bontango/AtariFA/README.md

# AtariFA

An Atari Gen1 pinball MPU on a low cost FPGA — a piggy-back replacement CPU board that
sits on the original Atari edge connectors, emulates the MC6800, provides RAM and ROM and
replaces most of the TTL around it.

Covers **Atarians, Time 2000, Airborne Avenger, Middle Earth and Space Riders**: all five
game ROMs live in the FPGA at once and are picked with a 3-bit DIP switch, with a free-play
option overlaid on top.

Ralf Thelen ('bontango') · <https://lisy.dev>

## User manuals

**Read online:** <https://bontango.github.io/AtariFA/>

- [User manual HW 1.x (English)](https://bontango.github.io/AtariFA/AtariFA_HWv1_x_user_manual.html)
- [Bedienungsanleitung HW 1.x (Deutsch)](https://bontango.github.io/AtariFA/AtariFA_HWv1_x_Bedienungsanleitung.html)
- [Manuel d'utilisation HW 1.x (Français)](https://bontango.github.io/AtariFA/AtariFA_HWv1_x_manuel_utilisateur.html)

---

## Boards

The same design runs on three piggy-back boards, across two FPGA families. They share
**one** top level (`top/AtariFA.vhd`) and one source tree; what differs per board is a
handful of pin locations, one constant, and — for the Cyclone IV board — which folder the
memory and PLL megafunctions come out of.

| Variant | Board | FPGA | Status |
|---|---|---|---|
| `cyclone_10_pcb` | AtariFA prototype (hardware version 0.7) with the lisy.dev Cyclone 10 piggy-back board - prototype only | 10CL006YE144C8G | lead variant, hardware tested through SW 0.1.5 |
| `cyclone_10_dev_open` | AtariFA PCB v1.0 carrying the 'dev_open' Cyclone 10 board | 10CL006YE144C8G | hardware tested on the bench since SW 0.3.0 |
| `cyclone_IV_dev_open` | AtariFA PCB v1.0 carrying the 'dev_open' board with a Cyclone IV | EP4CE6E22C8 | **not** hardware tested |

The version on the boot info display reads `<BoardId>.<SW_SUB1>.<SW_SUB2>`, so the leading
digit tells you which board you are looking at: `0.1.5` is the PCB board, `1.1.5` the
dev_open one, `2.1.5` the Cyclone IV dev_open one.

Differences between the boards, in full: pin-out; the dev_open boards have four on-board
status LEDs instead of three (D4 spare) and their own reset switch, and they route 3 of the
8 debug lines to the logic analyser header instead of all 8. The two dev_open variants are
the *same* board with a different chip on it: both are E144 with 6272 LE and 30 M9K, so the
design fits unchanged, but PIN_22 is a user I/O only on the Cyclone 10 — `dip_opt[1]` and
`dip_opt[3]` move one place each for the Cyclone IV.

## Layout

```
top/            the one top level, shared by every variant
rtl/common/     all functional modules + the version and type packages
rtl/cyclone_10/ the megafunctions generated for that FPGA family
rtl/cyclone_IV/ the same three, generated for Cyclone IV E - picked via RtlFamily
rom/            game ROMs, the sound ROM and the speech PCM
variants/<name>/  variant_pkg.vhd  BOARD_ID
                  device.tcl       FAMILY / DEVICE / Quartus version
                  pins.tcl         the pin locations
                  AtariFA.sdc      timing constraints
                  AtariFA.qpf      Quartus project file
                  AtariFA.cof      .sof -> .jic conversion setup
                  AtariFA.qsf      GENERATED - do not edit
scripts/        gen_qsf.ps1, check.ps1, build.ps1, release.ps1 + the .qsf fragments
bin/            release artefacts per board + changelog.txt
docs/           analyses, schematics, PinMAME reference sources
archive/        historic modules, in no build
```

## Documentation

**User manual: [online](https://bontango.github.io/AtariFA/AtariFA_HWv1_x_user_manual.html)**
(source `docs/AtariFA_HWv1_x_user_manual.html`) — for
whoever puts the board into a machine: DIP switches, boot sequence, sound paths, LEDs, free play.
In German: [online](https://bontango.github.io/AtariFA/AtariFA_HWv1_x_Bedienungsanleitung.html)
(`docs/AtariFA_HWv1_x_Bedienungsanleitung.html`), in French:
[online](https://bontango.github.io/AtariFA/AtariFA_HWv1_x_manuel_utilisateur.html)
(`docs/AtariFA_HWv1_x_manuel_utilisateur.html`).
Same chapter numbering, so a hint like "see chapter 4.3" fits all three.

Everything else in `docs/` is development material: measurements, schematic extracts and the
analyses behind individual design decisions. [`docs/WORKFLOW.md`](docs/WORKFLOW.md) is for working
on the source, not for using the board.

## Build

```powershell
scripts\check.ps1              # analysis & synthesis of every variant, fast
scripts\check.ps1 -Fit         # + fitter and timing, compared against scripts\baseline.csv
scripts\build.ps1 cyclone_10_pcb   # full compile + .jic
scripts\release.ps1 -Note "..."    # build all, copy to bin\, write changelog
```

Quartus Prime 22.1std.2 Lite Edition, `C:\intelFPGA_lite\22.1std\`. `quartus_sh` is not on
the PATH; the scripts know where it lives.

**Never edit `variants/<name>/AtariFA.qsf`** — it is generated. Change `device.tcl`,
`pins.tcl`, `variant.psd1` or the `scripts/files_*.tcl` lists and rerun `gen_qsf.ps1`
(`check.ps1` and `build.ps1` do that for you). Quartus writes into the file by itself when
the project is open in the IDE, which is exactly why it is regenerated before every build.

## Repository note

This repository used to be the single flat project folder `N:\Projekte\FPGA Atari\AtariFA`.
Its history moved here on 06.08.2026 when the second board variant made one shared tree
necessary. The two old folders `AtariFA\` and `AtariFA_dev_open\` are kept as a backup until
the rebuilt design has been on hardware — **do not commit or push from them.**

## Third party

CPU core `rtl/common/cpu68.vhd` by John Kent. Memory map, display mapping and the
switch/DIP handlers follow PinMAME `src/wpc/atari.c` (reference copies in `docs/`).
