bontango/AtariFA/tools/listing.txt

==============================================================================
AtariFA — Middle Earth 608/609 — 6800 Disassembly
==============================================================================
  ROM2 (609): 0x7000–0x77FF   ROM1 (608): 0x7800–0x7FFF
  RESET=7000  NMI=7EC6  IRQ=26F8  SWI=394E

━━━━━━━━━━━━━━━━━━━━━━━━━━━━━━━━━━━━━━━━━━━━━━━━━━━━━━━━━━━━━━━━━━━━━━━━━━━━━━
BOOT PATH TRACE  (from RESET=7000, call depth ≤ 6, max 8000 insn)
━━━━━━━━━━━━━━━━━━━━━━━━━━━━━━━━━━━━━━━━━━━━━━━━━━━━━━━━━━━━━━━━━━━━━━━━━━━━━━
  7000: 8E 00 60   ROM2_START:  LDS    #$0060
  7003: CE 11 FF                LDX    #$11FF
  7006: 6F 00 09                CLR    $00,X
  7008: 09 8C 10                DEX    
  7009: 8C 10 0F                CPX    #$100F
  700C: 26 F8 7A                BNE    $7006
  700E: 7A 00 C4                DEC    $00C4
  7011: 4F CE 20                CLRA   
  7012: CE 20 4F                LDX    #$204F
  7015: E6 00 2A                LDAB   $00,X
  7017: 2A 01 4C                BPL    $701A
  7019: 4C 49 09                INCA   
  701A: 49 09 8C                ROLA   
  701B: 09 8C 20                DEX    
  701C: 8C 20 4B                CPX    #$204B
  701F: 26 F4 CE                BNE    $7015
  7021: CE 7E 08                LDX    #$7E08
  7024: F6 20 0D                LDAB   $200D   ; DIP_STROBE13  *** IO: DIP_STROBE13
  7027: 2B 03 CE                BMI    $702C
  7029: CE 7E 28                LDX    #$7E28
  702C: BD 78 19                JSR    $7819
  7819: 5F DF 13                CLRB   
  781A: DF 13 9B                STX    $13   ; DISP_RAM+$13
  781C: 9B 14 D9                ADDA   $14   ; DISP_RAM+$14
  781E: D9 13 D7                ADCB   $13   ; DISP_RAM+$13
  7820: D7 13 97                STAB   $13   ; DISP_RAM+$13
  7822: 97 14 DE                STAA   $14   ; DISP_RAM+$14
  7824: DE 13 39                LDX    $13   ; DISP_RAM+$13
  7826: 39 B7 40                RTS    
          ; return → 702F
  702F: A6 00 97                LDAA   $00,X
  7031: 97 DF A6                STAA   $DF
  7033: A6 01 97                LDAA   $01,X
  7035: 97 E0 BD                STAA   $E0
  7037: BD 7F E9                JSR    $7FE9
  7FE9: 86 88 97                LDAA   #$88
  7FEB: 97 1C 97                STAA   $1C   ; DISP_RAM+$1C
  7FED: 97 1D CE                STAA   $1D   ; DISP_RAM+$1D
  7FEF: CE 00 10                LDX    #$0010
  7FF2: 09 A7 00                DEX    
  7FF3: A7 00 8C                STAA   $00,X
  7FF5: 8C FF FF                CPX    #$FFFF
  7FF8: 26 F8 39   VECTORS:     BNE    $7FF2
  7FFA: 39 4E 7E                RTS    
          ; return → 703A
  703A: C6 04 B6                LDAB   #$04
  703C: B6 20 03                LDAA   $2003   ; DIP_STROBE3  *** IO: DIP_STROBE3
  703F: 2A 02 C6                BPL    $7043
  7041: C6 06 D7                LDAB   #$06
  7043: D7 22 CE                STAB   $22   ; LAMP_RAM+$22
  7045: CE 7D F0                LDX    #$7DF0
  7048: 4F F6 20                CLRA   
  7049: F6 20 0F                LDAB   $200F   ; DIP_STROBE15  *** IO: DIP_STROBE15
  704C: 2A 01 4C                BPL    $704F
  704E: 4C 48 F6                INCA   
  704F: 48 F6 20                ASLA   
  7050: F6 20 0E                LDAB   $200E   ; DIP_STROBE14  *** IO: DIP_STROBE14
  7053: 2A 01 4C                BPL    $7056
  7055: 4C BD 78                INCA   
  7056: BD 78 19                JSR    $7819
  7819: 5F DF 13                CLRB     <<<
  781A: DF 13 9B                STX    $13   ; DISP_RAM+$13  <<<
  781C: 9B 14 D9                ADDA   $14   ; DISP_RAM+$14  <<<
  781E: D9 13 D7                ADCB   $13   ; DISP_RAM+$13  <<<
  7820: D7 13 97                STAB   $13   ; DISP_RAM+$13  <<<
  7822: 97 14 DE                STAA   $14   ; DISP_RAM+$14  <<<
  7824: DE 13 39                LDX    $13   ; DISP_RAM+$13  <<<
  7826: 39 B7 40                RTS      <<<
          ; return → 7059
  7059: A6 00 97                LDAA   $00,X
  705B: 97 1A 86                STAA   $1A   ; DISP_RAM+$1A
  705D: 86 11 97                LDAA   #$11
  705F: 97 6C BD                STAA   $6C
  7061: BD 7F 9C                JSR    $7F9C
  7F9C: B6 20 0B                LDAA   $200B   ; DIP_STROBE11  *** IO: DIP_STROBE11
  7F9F: D6 C4 97                LDAB   $C4
  7FA1: 97 C4 5D                STAA   $C4
  7FA3: 5D 2B 04                TSTB   
  7FA4: 2B 04 4D                BMI    $7FAA
  7FA6: 4D 2A 01                TSTA   
  7FA7: 2A 01 4F                BPL    $7FAA
  7FA9: 4F 39 DF                CLRA   
  7FAA: 39 DF DD                RTS    
          ; return → 7064
  7064: 26 05 BD                BNE    $706B
  7066: BD 7E C7                JSR    $7EC7
  7EC7: 4F B7 60                CLRA   
  7EC8: B7 60 00                STAA   $6000   ; AUDIO_OUT_6000  *** IO: AUDIO_OUT_6000
  7ECB: B7 10 80                STAA   $1080   ; SOL_LATCH1  *** IO: SOL_LATCH1
  7ECE: B7 10 84                STAA   $1084   ; SOL_LATCH2  *** IO: SOL_LATCH2
  7ED1: B7 10 84                STAA   $1084   ; SOL_LATCH2  *** IO: SOL_LATCH2
  7ED4: B7 10 88                STAA   $1088   ; SOL_LATCH3  *** IO: SOL_LATCH3
  7ED7: B7 10 8C                STAA   $108C   ; SOL_LATCH4  *** IO: SOL_LATCH4
  7EDA: 97 18 97                STAA   $18   ; DISP_RAM+$18
  7EDC: 97 83 BD                STAA   $83
  7EDE: BD 7F EF                JSR    $7FEF
  7FEF: CE 00 10                LDX    #$0010  <<<
  7FF2: 09 A7 00                DEX      <<<
  7FF3: A7 00 8C                STAA   $00,X  <<<
  7FF5: 8C FF FF                CPX    #$FFFF  <<<
  7FF8: 26 F8 39   VECTORS:     BNE    $7FF2  <<<
  7FFA: 39 4E 7E                RTS      <<<
          ; return → 7EE1
  7EE1: CE 00 08                LDX    #$0008
  7EE4: 86 FF 97                LDAA   #$FF
  7EE6: 97 6C BD                STAA   $6C
  7EE8: BD 7F F2                JSR    $7FF2
  7FF2: 09 A7 00                DEX      <<<
  7FF3: A7 00 8C                STAA   $00,X  <<<
  7FF5: 8C FF FF                CPX    #$FFFF  <<<
  7FF8: 26 F8 39   VECTORS:     BNE    $7FF2  <<<
  7FFA: 39 4E 7E                RTS      <<<
          ; return → 7EEB
  7EEB: D6 DF D7                LDAB   $DF
  7EED: D7 0E F6                STAB   $0E   ; DISP_RAM+$0E
  7EEF: F6 20 09                LDAB   $2009   ; DIP_STROBE9  *** IO: DIP_STROBE9
  7EF2: 2B 08 CE                BMI    $7EFC
  7EF4: CE 00 0C                LDX    #$000C
  7EF7: BD 7F F2                JSR    $7FF2
  7FF2: [loop ×4 — stop tracing this path]

━━━━━━━━━━━━━━━━━━━━━━━━━━━━━━━━━━━━━━━━━━━━━━━━━━━━━━━━━━━━━━━━━━━━━━━━━━━━━━
IO ACCESSES IN BOOT PATH
━━━━━━━━━━━━━━━━━━━━━━━━━━━━━━━━━━━━━━━━━━━━━━━━━━━━━━━━━━━━━━━━━━━━━━━━━━━━━━
  7024: LDAB  $200D  [DIP_STROBE13]
  703C: LDAA  $2003  [DIP_STROBE3]
  7049: LDAB  $200F  [DIP_STROBE15]
  7050: LDAB  $200E  [DIP_STROBE14]
  7F9C: LDAA  $200B  [DIP_STROBE11]
  7EEF: LDAB  $2009  [DIP_STROBE9]

━━━━━━━━━━━━━━━━━━━━━━━━━━━━━━━━━━━━━━━━━━━━━━━━━━━━━━━━━━━━━━━━━━━━━━━━━━━━━━
DETECTED TIGHT LOOPS (potential wait conditions)
━━━━━━━━━━━━━━━━━━━━━━━━━━━━━━━━━━━━━━━━━━━━━━━━━━━━━━━━━━━━━━━━━━━━━━━━━━━━━━
  Loop back to 7FF2
  Loop back to 7FF3
  Loop back to 7FF5
  Loop back to 7FF8
  Loop back to 7FFA

━━━━━━━━━━━━━━━━━━━━━━━━━━━━━━━━━━━━━━━━━━━━━━━━━━━━━━━━━━━━━━━━━━━━━━━━━━━━━━
FULL DISASSEMBLY — ROM2 (609)  0x7000–0x77FF
━━━━━━━━━━━━━━━━━━━━━━━━━━━━━━━━━━━━━━━━━━━━━━━━━━━━━━━━━━━━━━━━━━━━━━━━━━━━━━

ROM2_START:
  7000:  8E 00 60   LDS    #$0060
  7003:  CE 11 FF   LDX    #$11FF
  7006:  6F 00 09   CLR    $00,X
  7008:  09 8C 10   DEX    
  7009:  8C 10 0F   CPX    #$100F
  700C:  26 F8 7A   BNE    $7006
  700E:  7A 00 C4   DEC    $00C4
  7011:  4F CE 20   CLRA   
  7012:  CE 20 4F   LDX    #$204F
  7015:  E6 00 2A   LDAB   $00,X
  7017:  2A 01 4C   BPL    $701A
  7019:  4C 49 09   INCA   
  701A:  49 09 8C   ROLA   
  701B:  09 8C 20   DEX    
  701C:  8C 20 4B   CPX    #$204B
  701F:  26 F4 CE   BNE    $7015
  7021:  CE 7E 08   LDX    #$7E08
  7024:  F6 20 0D   LDAB   $200D   ; DIP_STROBE13
  7027:  2B 03 CE   BMI    $702C
  7029:  CE 7E 28   LDX    #$7E28
  702C:  BD 78 19   JSR    $7819
  702F:  A6 00 97   LDAA   $00,X
  7031:  97 DF A6   STAA   $DF
  7033:  A6 01 97   LDAA   $01,X
  7035:  97 E0 BD   STAA   $E0
  7037:  BD 7F E9   JSR    $7FE9
  703A:  C6 04 B6   LDAB   #$04
  703C:  B6 20 03   LDAA   $2003   ; DIP_STROBE3
  703F:  2A 02 C6   BPL    $7043
  7041:  C6 06 D7   LDAB   #$06
  7043:  D7 22 CE   STAB   $22   ; LAMP_RAM+$22
  7045:  CE 7D F0   LDX    #$7DF0
  7048:  4F F6 20   CLRA   
  7049:  F6 20 0F   LDAB   $200F   ; DIP_STROBE15
  704C:  2A 01 4C   BPL    $704F
  704E:  4C 48 F6   INCA   
  704F:  48 F6 20   ASLA   
  7050:  F6 20 0E   LDAB   $200E   ; DIP_STROBE14
  7053:  2A 01 4C   BPL    $7056
  7055:  4C BD 78   INCA   
  7056:  BD 78 19   JSR    $7819
  7059:  A6 00 97   LDAA   $00,X
  705B:  97 1A 86   STAA   $1A   ; DISP_RAM+$1A
  705D:  86 11 97   LDAA   #$11
  705F:  97 6C BD   STAA   $6C
  7061:  BD 7F 9C   JSR    $7F9C
  7064:  26 05 BD   BNE    $706B
  7066:  BD 7E C7   JSR    $7EC7
  7069:  20 95 86   BRA    $7000
  706B:  86 0F 97   LDAA   #$0F
  706D:  97 18 86   STAA   $18   ; DISP_RAM+$18
  706F:  86 01 97   LDAA   #$01
  7071:  97 83 9B   STAA   $83
  7073:  9B 9D 97   ADDA   $9D
  7075:  97 9D 84   STAA   $9D
  7077:  84 0F 81   ANDA   #$0F
  7079:  81 0F 26   CMPA   #$0F
  707B:  26 6B 7C   BNE    $70E8
  707D:  7C 00 B3   INC    $00B3
  7080:  26 1B 86   BNE    $709D
  7082:  86 FF BD   LDAA   #$FF
  7084:  BD 7F EF   JSR    $7FEF
  7087:  86 FB 97   LDAA   #$FB
  7089:  97 B3 D6   STAA   $B3
  708B:  D6 29 27   LDAB   $29   ; LAMP_RAM+$29
  708D:  27 0E D1   BEQ    $709D
  708F:  D1 E1 26   CMPB   $E1
  7091:  26 01 5F   BNE    $7094
  7093:  5F 5C D7   CLRB   
  7094:  5C D7 29   INCB   
  7095:  D7 29 5F   STAB   $29   ; LAMP_RAM+$29
  7097:  5F D7 17   CLRB   
  7098:  D7 17 BD   STAB   $17   ; DISP_RAM+$17
  709A:  BD 7A 1D   JSR    $7A1D
  709D:  96 C5 81   LDAA   $C5
  709F:  81 1B 26   CMPA   #$1B
  70A1:  26 02 86   BNE    $70A5
  70A3:  86 FA 8B   LDAA   #$FA
  70A5:  8B 06 97   ADDA   #$06
  70A7:  97 C5 CE   STAA   $C5
  70A9:  CE 7D BE   LDX    #$7DBE
  70AC:  BD 78 19   JSR    $7819
  70AF:  A6 00 BD   LDAA   $00,X
  70B1:  BD 7C 09   JSR    $7C09
  70B4:  A6 01 BD   LDAA   $01,X
  70B6:  BD 7C 09   JSR    $7C09
  70B9:  A6 02 BD   LDAA   $02,X
  70BB:  BD 7C 09   JSR    $7C09
  70BE:  8C 7D D6   CPX    #$7DD6
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

━━━━━━━━━━━━━━━━━━━━━━━━━━━━━━━━━━━━━━━━━━━━━━━━━━━━━━━━━━━━━━━━━━━━━━━━━━━━━━
NMI ISR  context  @7EC6  (±32 bytes)
━━━━━━━━━━━━━━━━━━━━━━━━━━━━━━━━━━━━━━━━━━━━━━━━━━━━━━━━━━━━━━━━━━━━━━━━━━━━━━
  7EC2:  01 20 45   NOP    
  7EC3:  20 45 33   BRA    $7F0A
  7EC5:  33 3B 4F   PULB   

NMI_ISR:
  7EC6:  3B 4F B7   RTI    
  7EC7:  4F B7 60   CLRA   
  7EC8:  B7 60 00   STAA   $6000   ; AUDIO_OUT_6000
  7ECB:  B7 10 80   STAA   $1080   ; SOL_LATCH1
  7ECE:  B7 10 84   STAA   $1084   ; SOL_LATCH2
  7ED1:  B7 10 84   STAA   $1084   ; SOL_LATCH2
  7ED4:  B7 10 88   STAA   $1088   ; SOL_LATCH3
  7ED7:  B7 10 8C   STAA   $108C   ; SOL_LATCH4
  7EDA:  97 18 97   STAA   $18   ; DISP_RAM+$18
  7EDC:  97 83 BD   STAA   $83
  7EDE:  BD 7F EF   JSR    $7FEF
  7EE1:  CE 00 08   LDX    #$0008
  7EE4:  86 FF 97   LDAA   #$FF
  7EE6:  97 6C BD   STAA   $6C
  7EE8:  BD 7F F2   JSR    $7FF2
  7EEB:  D6 DF D7   LDAB   $DF
  7EED:  D7 0E F6   STAB   $0E   ; DISP_RAM+$0E
  7EEF:  F6 20 09   LDAB   $2009   ; DIP_STROBE9
  7EF2:  2B 08 CE   BMI    $7EFC
  7EF4:  CE 00 0C   LDX    #$000C
  7EF7:  BD 7F F2   JSR    $7FF2
  7EFA:  20 04 96   BRA    $7F00
  7EFC:  96 E0 97   LDAA   $E0
  7EFE:  97 0A 96   STAA   $0A   ; DISP_RAM+$0A
  7F00:  96 1A      LDAA   $1A   ; DISP_RAM+$1A
