bontango/AtariFA/docs/Auxiliary_PCB.png

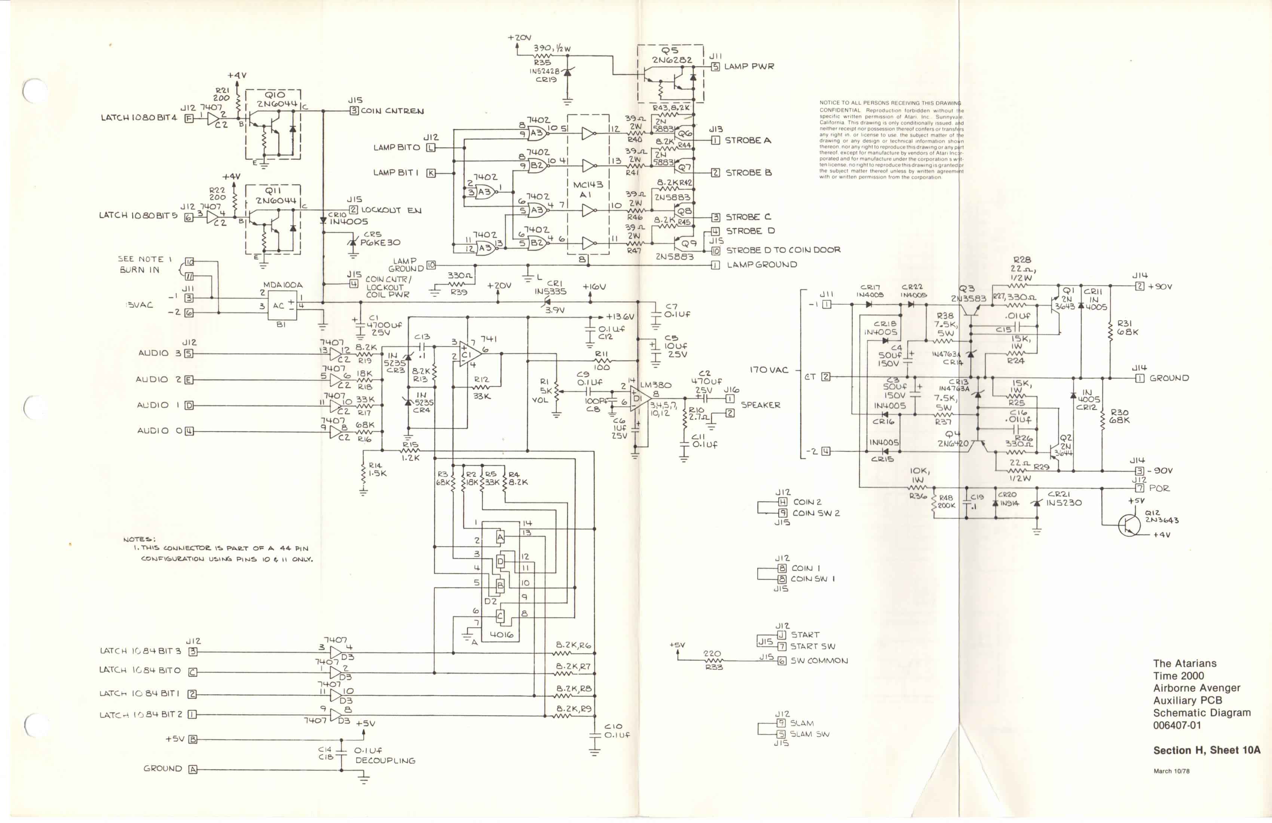
docs/Auxiliary_PCB.png
