bontango/AtariFA/docs/Display_Logic.png

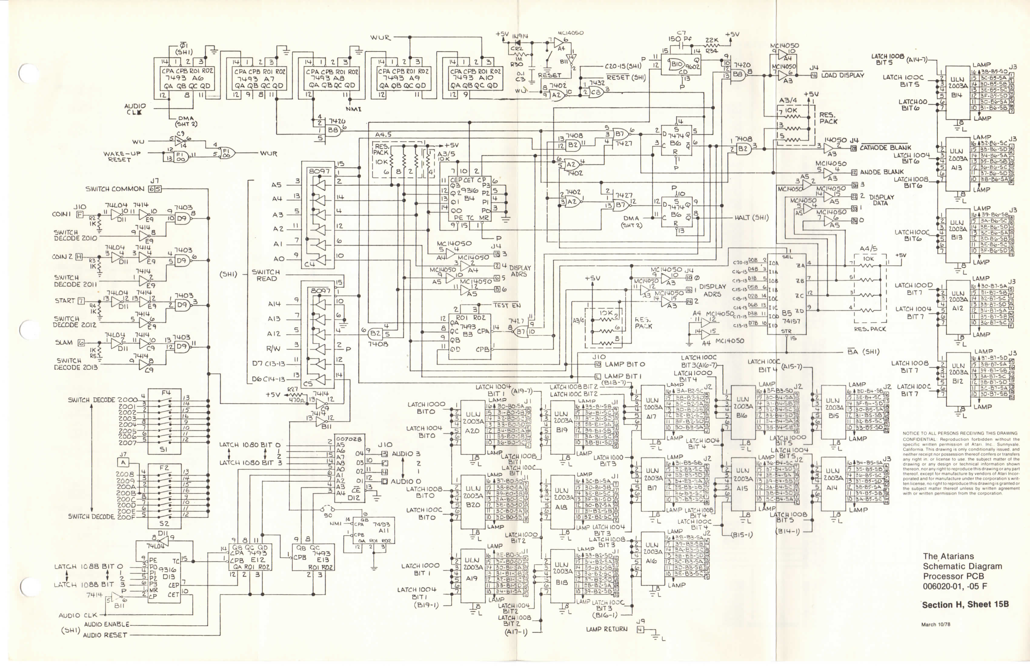
docs/Display_Logic.png
