bontango/AtariFA/docs/Lamp_Logic2.png

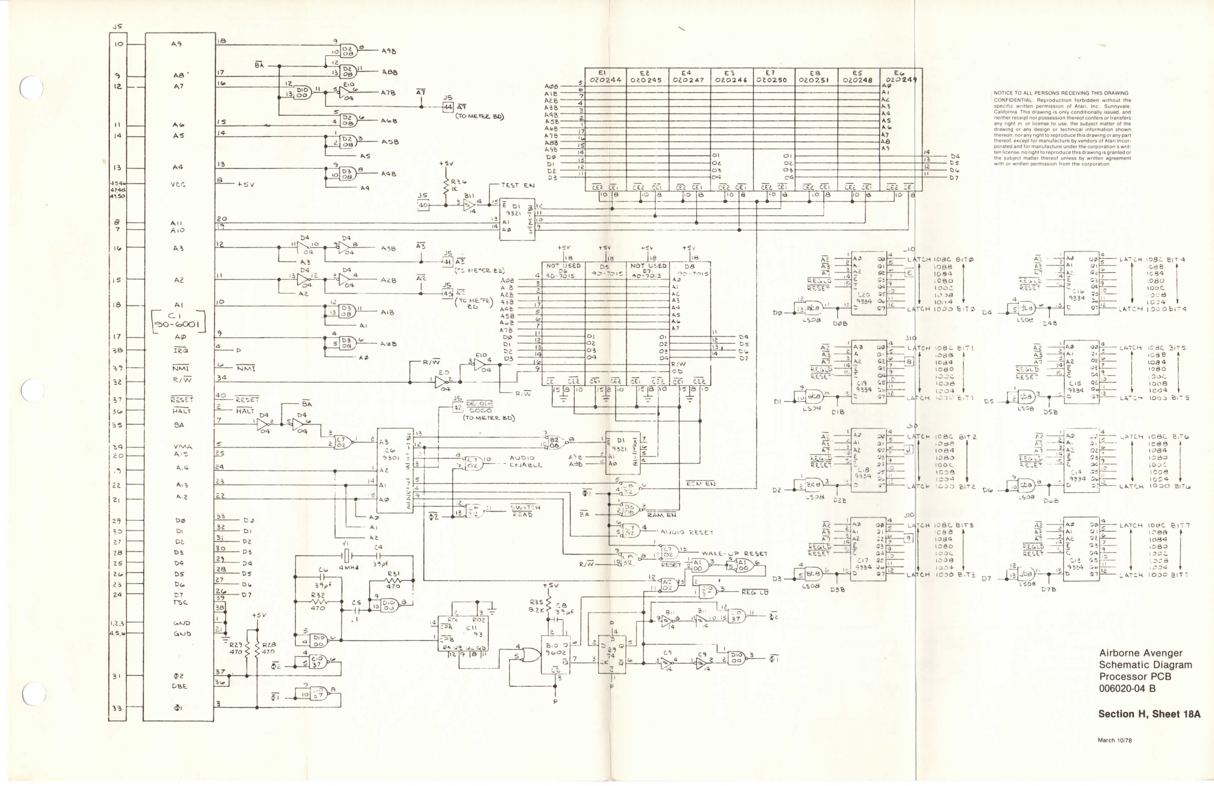
docs/Lamp_Logic2.png
