bontango/AtariFA/docs/Lamp_Logic.png

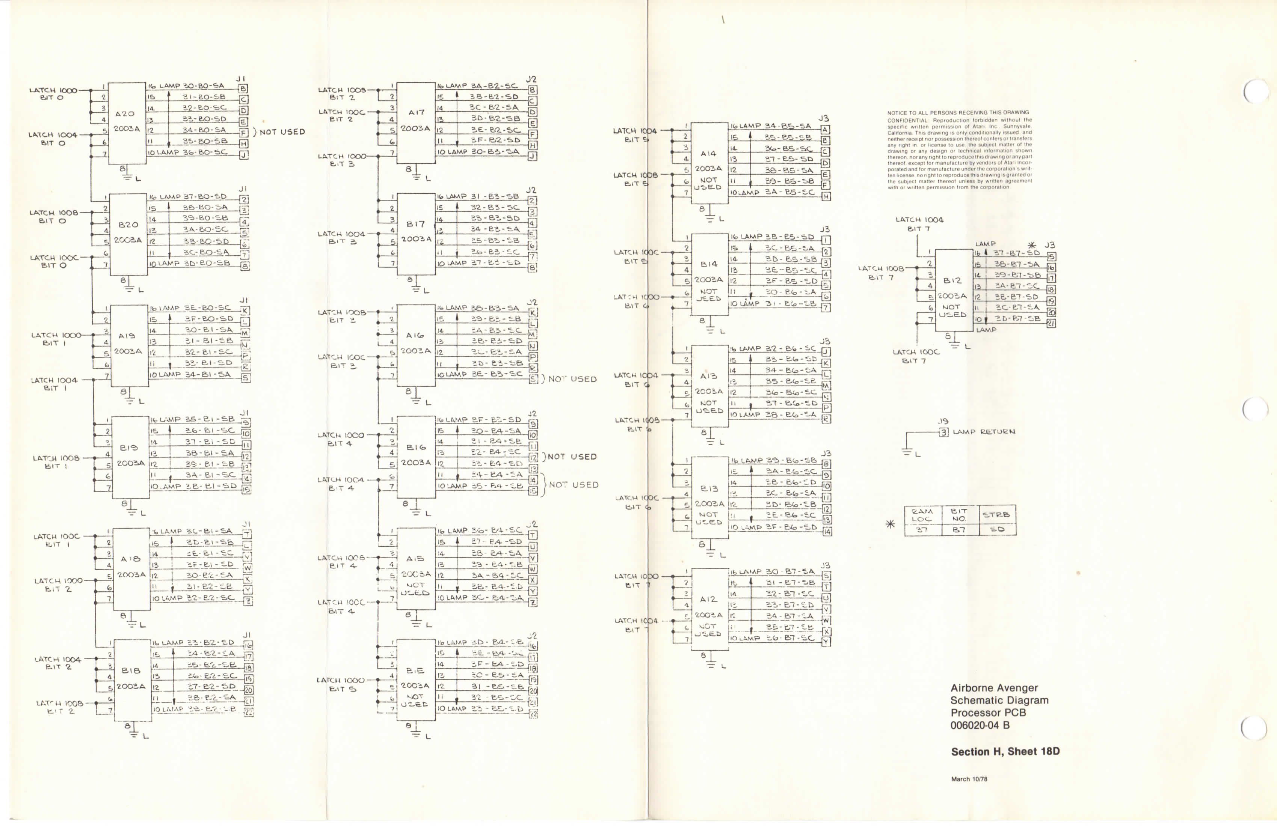
docs/Lamp_Logic.png
