bontango/AtariFA/docs/Switch_Sol_Logic.png

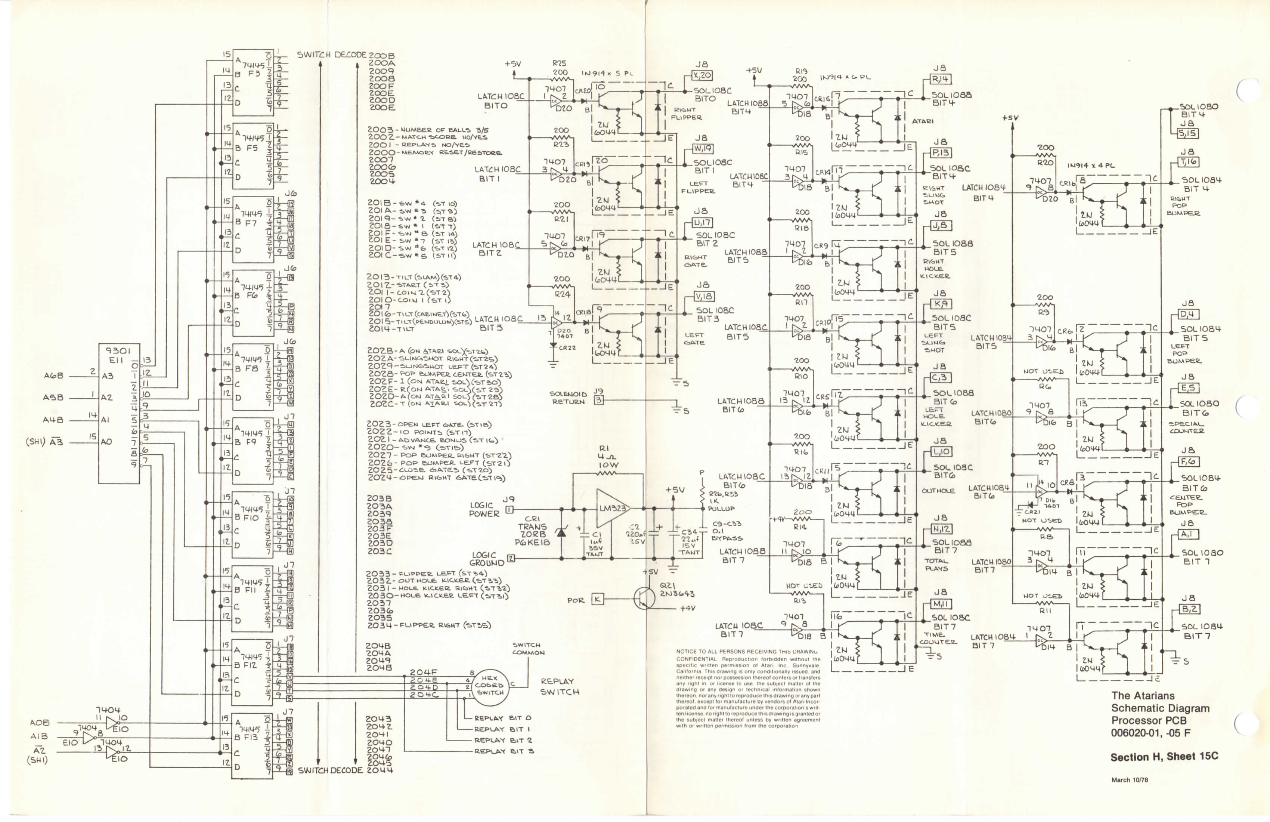
docs/Switch_Sol_Logic.png
