bontango/AtariFA/bin/changelog.txt

2026-08-09 17:41  version .1.4
  lamp_matrix: 24th shift clock widened from one clock period (20 ns, right at the 74HC595 minimum) to a full tick - measured on a logic analyser, see docs/Lamp_Refresh_Analysis.md 6.7.1. No behaviour change. cyclone_10_pcb verified on the prototype up to 0.1.3; 0.1.4 itself not yet played on the machine. cyclone_10_dev_open NEVER hardware tested.
  cyclone_10_dev_open    1.1.4    AtariFA_v114.jic  sha256:E5FEFDB46FF49BE3
  cyclone_10_pcb         0.1.4    AtariFA_v014.jic  sha256:F22304F14500A849

2026-08-10 10:32  version .1.5
  lamp matrix now scans at the original 488 Hz frame - 512 us per strobe column, DWELL_CYCLES 12500 to 25100
  cyclone_10_dev_open    1.1.5    AtariFA_v115.jic  sha256:DF8A8896A30A32B9
  cyclone_10_pcb         0.1.5    AtariFA_v015.jic  sha256:F8D339644CAC3FE9

2026-08-13 11:36  version .1.7
  lamp matrix: three dead-time steps for the Aux board column driver instead of one - series value now ~60 us (SETTLE_CYCLES 2500), Options DIP 6 adds ~110 us, DIP 5 = ON keeps the original timing, phase length unchanged at 512 us in all three positions. Field tested on an Airborne Avenger and a Middle Earth: the DIP 5 A/B reproduces the pre-glow on command and the base glow of the LED retrofits is gone, so both 0.1.6 fixes are confirmed on hardware. Still open: 595 group 6 (ULN2003A A20, FA-Control lamps 20..23) keeps glowing and DIP 6 makes no difference there - measurement plan in docs/Lamp_Preglow_Experiment.md 6. cyclone_10_dev_open NEVER hardware tested.
  cyclone_10_dev_open    1.1.7    AtariFA_v117.jic  sha256:09EBA3001B8058FF
  cyclone_10_pcb         0.1.7    AtariFA_v017.jic  sha256:2ADBE48048FCA496

2026-08-13 11:54  version .1.8
  MEASUREMENT BUILD, not a series standard - one constant against 0.1.7: SETTLE_LONG_CYCLES 5000 to 20000, so Options DIP 6 = ON now gives ~400 us of column dead time instead of ~110 us, at the price of three quarters of the brightness (duty 5.0 percent instead of 22.1). Everything else is 0.1.7. Purpose: decide once whether the glow of 595 group 6 (ULN2003A A20, FA-Control lamps 20..23) comes from the column driver's turn-off time at all - 110 us changed nothing, and per the base-charge estimate in docs/Lamp_Refresh_Analysis.md 3.3 that is not yet an acquittal. Field procedure: program 0.1.8, check the info display shows 018, then toggle DIP 6 while the game runs. Glow weaker or gone with ON = it was the column, and the smallest value that still works becomes the new series value. No change at all = the column is settled, remaining cause is the ULN residual current (field fix: 2.2 kOhm across the socket). For playing, set DIP 6 = OFF or stay on 0.1.7. cyclone_10_dev_open NEVER hardware tested.
  cyclone_10_dev_open    1.1.8    AtariFA_v118.jic  sha256:8289A36A7BE0FFCF
  cyclone_10_pcb         0.1.8    AtariFA_v018.jic  sha256:0F6C151182BFD8E0

2026-08-13 17:41  version .1.9
  Lamp column dead time becomes a four-position ladder on Options DIP 5 + 6, superseding the 0.1.8 measurement build. OFF/OFF is the series value at about 65 us (duty 21.8 percent), OFF/ON about 250 us (12.8), ON/ON about 400 us (5.5), and DIP 5 on its own still selects the original MPU timing with no dead time at all (24.5). DIP 5 alone and DIP 6 alone therefore keep their 0.1.7 meaning - only the combination changed, which used to be the original timing under the DIP 5 overrides DIP 6 rule. Reason: the Middle Earth reports 0.1.7 FIXES its lamp glow, so the longer dead time is the right lever, while the Airborne tester has confirmed he really ran 0.1.7 and still sees 595 group 6 glowing - 110 us are simply too short there. A single extreme value answers a yes or no question but leaves nothing anyone can play on, so the tester now picks the smallest step that works on his machine. The phase stays 512 us in all four positions because the dwell absorbs the difference, and 24597 clk is the hard ceiling, so 400 us is as far as this goes. Field procedure: program 0.1.9, check the info display shows 019, then DIP 6 = ON and if needed DIP 5 + 6 = ON while the game runs. If the glow survives 400 us it is not the column - remedy is 2.2 kOhm across the socket, see chapter 4.2.5 of both manuals. cyclone_10_dev_open NEVER hardware tested.
  cyclone_10_dev_open    1.1.9    AtariFA_v119.jic  sha256:F05E67F36CB91F56
  cyclone_10_pcb         0.1.9    AtariFA_v019.jic  sha256:6796AE32C05B11DF

2026-08-14 13:02  version .2.0
  FA-Control solenoid numbers are 1-based from now on: tile n is driver Qn of the schematic, 21 is the coin counter and 22 the coin door lockout. LISY counts coils that way (lisy_5_28/src/lisy/lisy_w.c, "sol number starts with 1") and so does the original documentation, which makes the previous 0..21 the odd one out - a real LISY host would have hit the second coil when sending 1 and could never reach the 22nd at all, because par1 < N_SOL rejected 22. Four opcode handlers in rtl/fa_control/fa_control.vhd changed (G_STAT_SOL, S_SOL_ON, S_SOL_OFF, S_PULSE_SOL): range test is now par1 >= 1 and par1 <= N_SOL, vector index is par1-1. sol_r stays 0-based, so the top level and its gen_fa_sol wiring are untouched, and lamps (0..83) and switches (0..79) keep their 0 base on purpose - the reason is written into the module header. THE ESP32 SIDE MUST MOVE WITH IT: FA_Control 1.16 or newer. An older web firmware against this bitstream fires the coil one position off, so do not mix. Field procedure: program 0.2.0, check the info display shows 020, connect FA-Control with Options DIP 4 = ON and verify that tile 1 fires Q1, tile 20 fires Q20 and tiles 21/22 are coin counter and lockout; tiles 14 and 18 are the unfitted Q14/Q18 and must do nothing. Second part of this release, comments and manuals only, no logic change: the D2 LED never blinked at the 0.6 Hz both manuals promised and never could. cpu_fetch_cnt counts ROM access BURSTS, not time, so bit 20 yields no fixed frequency at all - 0.6 Hz would need 1.26 M edges per second against a 1 MHz cpu_clk, and the construction caps out at 0.24 Hz. Measured is about 3 s per phase and it depends on the game rom. D3 was right all along at 0.477 Hz, and what looks like a one second blink is its half period. Both manuals, the quick reference and the code comments now say so. cyclone_10_dev_open NEVER hardware tested.
  cyclone_10_dev_open    1.2.0    AtariFA_v120.jic  sha256:AA2A2842E4EC74B2
  cyclone_10_pcb         0.2.0    AtariFA_v020.jic  sha256:17491087DE0EAEE5

2026-08-20 11:53  version .2.1
  0x2000 is a normal dip position now, sw_state(0), with only bit 6 overwritten by dma_toggle, exactly as PinMAME dipg1_r does it for offset 0. It used to be a fully synthesised byte with bit 7 hard 0 and bits 5..0 hard 1 - that matched the two evaluated bits only with the dip OFF (coin/credit factory setting), so a CLOSED dip 0 was invisible to the game while FA-Control showed it correctly on tile 0 (fa_sw_state comes raw from sw_state). Rom proof in docs/Switch_Reading_Analysis.md: 0x721C is the 0x2000 position of the dip loop 0x7200-0x7229, which collects bit 7 by LDAB/BPL/INCA/ROLA, so bit 7 MUST be the dip; bit 6 is the display sync the rom polls with ANDA #$40 at 0x78BE/0x78C9. NOT RELEASED as a build of its own - superseded four hours later by 0.3.0, which carries this fix. No bitstream and no baseline entry exist for this step; the 0.3.0 baseline note carries its deltas.
  cyclone_10_dev_open    1.2.1    (not released)
  cyclone_10_pcb         0.2.1    (not released)

2026-08-20 18:08  version .3.0
  Background music over the DFPlayer Mini fitted as Audio1. The output SB_Audio, tied to a constant 0 until now, is a 9600 baud 8N1 uart to the player RX pin - CONFIRMED on the hardware for both boards (pcb PIN_7, dev_open PIN_111). New module rtl/common/dfplayer_cmd.vhd, sender is a second instance of the existing rtl/fa_control/uart_tx.vhd with g_CLKS_PER_BIT 5208, not the GottFA1_PLuS home-made shifter on its own 9600 Hz clock - one clock domain fewer and nothing to add to the sdc. Frame is 7E FF 06 <cmd> 00 <par1> <par2> EF, 8 bytes without checksum, commands 0x42 status, 0x06 volume, 0x17 repeat folder 02, 0x0D resume, 0x0E pause. TRIGGER is the flipper control relay Q12, latch 0x1088 bit 6, the Atari counterpart of the Gottlieb game over relay - proof from the Space Riders manual table 5-6, self test 12 and the Middle Earth rom (7F36 game start, 77BC game over), derivation in docs/Background_Music.md. It is taken from the same mux as the physical coil output, so FA-Control can drive it on the bench, and it drops on tilt, which pauses the music exactly as the original relay behaves. GLITCH_CYCLES re-checks the trigger after 500 ms so a single coil pulse from FA-Control cannot start the music. Enabled by Options DIP 1, read at boot, which was free since the FRAM feature went on hold - the manuals now document it as the music switch. Card layout: a folder 02 with 001.mp3, 002.mp3 ... played in a loop; the same card works on a GottFA1_PLuS. No mixer and no ducking, music and game sound are separate analog paths meeting at the amplifier. This release also carries the 0.2.1 dip fix for 0x2000 that was never released on its own. Memory UNCHANGED at 202752 and pins UNCHANGED at 85 of 89, the acceptance criteria; comb +158 and reg +92 against 0.2.1 for the new module; slack 2.897 -> 1.868, the largest single drop in a while and worth watching at the next feature. HARDWARE: 0.3.0 was programmed and RUNS ON BOTH BOARDS - for cyclone_10_dev_open that is the first time the variant has ever run on hardware. STILL OPEN: the music function itself, whether the player really starts and pauses with the flipper relay. Field procedure: put the card in, set Options DIP 1 = ON, power cycle (read at boot), check the info display shows 030, start a game.
  cyclone_10_dev_open    1.3.0    AtariFA_v130.jic  sha256:A75C555AC7520A91
  cyclone_10_pcb         0.3.0    AtariFA_v030.jic  sha256:45E81D0E67D4C42D

2026-08-31 19:37  version .3.2
  SW 0.3.2 - background music: outhole trigger (0.3.1) plus the RecelFA v0.6 command path. DFPlayer confirmed PLAYING on cyclone_10_dev_open on the bench; not yet tried on a machine, so the five outhole switch numbers stay unconfirmed except Airborne.
  cyclone_10_dev_open    1.3.2    AtariFA_v132.jic  sha256:8FF59EE180EB3284
  cyclone_10_pcb         0.3.2    AtariFA_v032.jic  sha256:8C0AD93A08F9F0AE

2026-09-02 12:51  version .3.3
  third board variant: cyclone_IV_dev_open (BOARD_ID 2, EP4CE6E22C8). No functional change to the logic - .3.3 exists so the new board gets an artefact without overwriting the shipped .3.2 files. NOT hardware tested on the Cyclone IV board.
  cyclone_10_dev_open    1.3.3    AtariFA_v133.jic  sha256:B9F3FF033B220372
  cyclone_10_pcb         0.3.3    AtariFA_v033.jic  sha256:53727C84E63B150C
  cyclone_IV_dev_open    2.3.3    AtariFA_v233.jic  sha256:F3C64BFFA0CAEFCB

2026-11-10 11:19  version .3.4
  Space Riders free play: the 3rd player display no longer shows 07 when a second player is added. The fault was in the free play rom spacerf itself, not in the FPGA - its credit check patch at 0x7752 read 97 04 = STAA $04, and the start routine at 0x76B2 calls that code only with A = 07, so 07 landed in RAM $0004 = the last two digits of player 3 (PinMAME ram_w). On the first start the game start routine clears the displays again, on adding player 2 it does not. Fix: 0x752/0x753 -> 01 01 (NOP NOP), checksum byte 0x000 42 -> DB so the rom byte sum stays 00. rom/freeplay/spacerf.hex and FP_PATCHES changed accordingly, still 42 bytes. The other four free play roms were checked and are clean. Reg 1544 / Memory 202752 unchanged on all three variants, comb drift -14..+11 is constant folding. HARDWARE 2026-11-10: cyclone_10_pcb (FPGA_board_v4.x) 0.3.4 tested OK on Space Riders free play - player 3 stays dark when player 2 is added. The two dev_open variants not tested with 0.3.4.
  cyclone_10_dev_open    1.3.4    AtariFA_v134.jic  sha256:E060DC30F4C5CA73
  cyclone_10_pcb         0.3.4    AtariFA_v034.jic  sha256:7D2AC7F71AF6C1AE
  cyclone_IV_dev_open    2.3.4    AtariFA_v234.jic  sha256:FEB7FAA7EF4829CD

2026-11-11 19:42  version .4.4
  FRAM active again (SW 0.4.0..0.4.4): option DIP 2 ON saves credits, high score and the last scores of each of the five games in the FRAM, OFF switches it off and erases the selected game at boot. Last scores are shown after power on until the first game, the high score alternates with the normal display in attract mode (8 s / 4 s). Credits: counter addresses found by ROM disassembly (Atarians $CE, Time 2000 $D6, Airborne $D5 binary, Middle Earth $1D, Space Riders $B7); every change is saved at once, after every CPU start the CPU is halted and the counter plus the credit display byte $1D are written back. Boot info: player 4 left = FRAM status, credit display = saved credits. read_the_dips samples 50 us after each strobe change (was 1 us). Memory 202752 unchanged, LE 96 % on all three. HARDWARE 2026-11-11: cyclone_10_pcb (FPGA_board_v4.x) tested OK on the bench (high score 0.4.2, credits 0.4.4). The two dev_open variants built, not tested on hardware.
  cyclone_10_dev_open    1.4.4    AtariFA_v144.jic  sha256:B14DBDDC7094FF11
  cyclone_10_pcb         0.4.4    AtariFA_v044.jic  sha256:80E960CFC372575A
  cyclone_IV_dev_open    2.4.4    AtariFA_v244.jic  sha256:8499BE6815E04C9A
