bontango/AtariFA/(commit log)

2026-05-23 Initial commit: AtariFA Gen1 MPU FPGA project (CPU + ROMs + Display)
    Cyclone IV E (EP4CE6F17C8) implementation of the Atari Gen1 Pinball MPU
    (MC6800-based). Current state: John Kent cpu68 core, Middle Earth ROMs,
    512-byte SRAM, display multiplex, and SN7493-based DMA clock chain.
2026-05-25 Implement Phase A1 Watchdog + apply B1-B3 fixes
    Watchdog (watchdog.vhd, new module):
    - Decodes write to 0x4000; kick pulse resets 24-bit counter
    - ~250 ms timeout (12.5 M clk_50 cycles, Generic TIMEOUT_COUNT)
    - On timeout: 50-cycle wd_reset pulse for power-on reset and hang recovery
    - wd_reset OR'd into reset_h alongside external reset_l_stable
    Previously staged but uncommitted fixes:
    - B1: NMI connected (nmi => not dma_int)
    - B2: Synchronous RAM write strobe via cpu_clk edge-detect in clk_50 domain
    - B3: SDC updated (cpu_clk_gen constraint commented out, derive_pll_clocks active,
    IO delay constraints added); cpu_clock PLL (altpll) replaces cpu_clk_gen
    Also: gitignore extended for gr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
    [AtariFA.vhd, watchdog.vhd]
2026-05-25 Apply code-review fixes B6, B7, B8
    B6: Remove dead solenoid-latch decode
    - Delete signals latch1080/84/88/8C and solenoid_latch
    - Simplify ram_cs to ram_cs_normal or ram_cs_mirror
    - Writes to 0x1080/84/88/8C now fall through to RAM mirror
    (intentional until Phase B implements proper latches with output registers)
    B7: Feed reset_l_stable (synchronized) to display modules
    - BM and DT instances: show => reset_l_stable instead of raw reset_l
    - Atari.sdc: set_false_path -from [get_ports reset_l]
    B8: Default cpu_din bus to 0xFF (open bus)
    - Was 0x00 (TEST opcode on 6800, masks mis-fetches)
    - 0xFF matches real hardware open-bus behavior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
    [AtariFA.vhd]
2026-05-25 B9: Replace 3x SN7493 ripple chain with single 9-bit synchronous counter
    The three SN7493 instances formed a 12-bit binary counter counting
    cpu_clk rising edges. Only bits 7 and 8 were live (dma_int for NMI).
    Replacement: a single 9-bit std_logic_vector counter in the existing
    clk_50 process, using the same rising-edge detect (cpu_clk_d1 and not
    cpu_clk_d2) as the original SN7493 reg1/reg2 logic.
    - dma_int <= not (dma_counter(7) and dma_counter(8)) -- NMI, period 512us
    - dma_clk <= dma_counter(0) -- reserved
    - audio_clk <= dma_counter(2) -- reserved for Phase C audio
    - Decode is now glitch-free (all bits update synchronously)
    - Remove SN7493.vhd and its QSF entry (no longer used)
    Co-Aut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
    [AtariFA.vhd]
2026-05-25 Fix Hold timing violations + add nmi/dip/display logic
    SDC: rename Atari.sdc -> AtariFA.sdc; add set_false_path from
    cpu_clk (PLL clk[0]) to cpu_clk_d1 to suppress spurious Hold
    violations caused by clock-used-as-data edge-detect pattern.
    AtariFA.vhd: add nmi_level/dma_toggle signals, sw_cs/dip_cs
    chip-selects with dip_value (dma_toggle at bit6 of 0x2000),
    and display shadow buffer process (RAM 0x00-0x1F sniffer).
    CLAUDE.md: document SDC filename, false_path convention, Phase D progress.
    [AtariFA.vhd]
2026-05-25 Add Phase B lamp_driver (TPIC6B595N), wiring disabled in AtariFA.vhd
    84 lamps via 11x TPIC6B595N cascade, static latched (replaces 9334+ULN2003A),
    fed from a RAM 0x30-0x3F write-sniffer shadow buffer analogous to the display.
    Wiring in AtariFA.vhd (ports, lamp_state, sniffer, instance) is commented out
    until the display milestone is finished.
    [AtariFA.vhd]
2026-06-06 Fix 888888 power-up loop: sw/DIP reads return 0xFF (active-low pull-ups)
    Root cause found via static 6800 disassembly (tools/dis6800.py):
    Boot code at $7F9C polls $200B (DIP_STROBE11); returning 0x00 always
    caused A=0 at $7064 → JSR $7EC7 (writes 0x88='8' to display RAM) →
    BRA $7000 → infinite restart loop, displays stuck at '888888'.
    Fixes:
    - sw_cs (switch matrix 0x2010-0x204F): 0x00 → 0xFF (all switches open)
    - dip_value (0x2001-0x200F): x"00" → x"FF" (all DIP bits = open/inactive)
    - dip_value (0x2000): bits5-0 set to 1; bit6=dma_toggle retained
    (display-sync loops at $78BE/$78C9 in ROM1 poll exactly this bit)
    Also adds: NVRAM 0x0200 fake register, DIAG_SEL 4-way diagnostic,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
    [AtariFA.vhd, watchdog.vhd]
2026-06-06 Add DBG_MODE PC-trace + CPU-fetch LED for bring-up diagnosis
    Two diagnostic improvements to localise the '268793' display freeze:
    1. DBG_MODE constant (0/1/2) routes debug_signal[7:0] at compile time:
    - 0 = existing cpu_clk/vma/rw/ram_wren/NMI/wd_reset/dma_toggle/rom_cs mix
    - 1 = cpu_addr(7:0) -- PC low byte, readable as static value on LA
    - 2 = cpu_addr(15:8) -- PC high byte
    Implemented via generate blocks; no logic overhead in mode 0.
    2. LED_D2 now shows cpu_fetch_cnt(20) instead of heartbeat_div(24):
    counts rising edges of (rom1_cs or rom2_cs) in clk_50.
    Blinks ~0.6 Hz when cpu68 fetches ROM instructions; stays static
    if CPU is halted or stuck in a RAM poll loop wi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
    [AtariFA.vhd]
2026-06-06 Fix attract freeze: switch matrix idle = 0x00 not 0xFF
    Root cause of the '268793' display freeze, confirmed via LA + ROM disassembly:
    The attract main loop (0x70F4-0x70FD) ORs three switch rows and branches on
    bit 7: if any bit7 is set, it enters the 'switch pressed' handler and loops
    back forever (BRA 0x70E8), never advancing attract.
    Our blanket 0xFF for sw_cs (0x2010-0x204F) had bit7=1, trapping the CPU in
    that handler permanently.
    PinMAME atari.c Gen1 swg1_r(): idle (no switch pressed) returns 0x00, pressed
    returns 0xFF (non-inverted). Correct idle value is 0x00.
    DIP registers 0x2000-0x200F (dip_value) are unaffected and remain correct.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
    [AtariFA.vhd]
2026-06-06 Wire 4 test-board buttons to game inputs via 2-FF synchronizer
    switch[1]=Test→$200B, [2]=Coin1→$2010, [3]=Coin2→$2011, [4]=Start→$2013.
    Active-low buttons (pull-up idle='1') inverted to PinMAME swg1_r polarity
    (pressed=0xFF, idle=0x00). Test-switch follows pin directly: idle→FF=normal
    boot, pressed→00=888888 segment test (ROM1@7F9C). 2-FF sync added for B4.
    [AtariFA.vhd]
2026-06-06 Update CLAUDE.md: testboard bring-up complete, roadmap updated
    Document verified results: Test/Coin1/Coin2 switches working on GottFA3
    testboard. Start needs ball-detection (not an FPGA bug). WD deliberately
    disconnected from reset_h (Attract Mode doesn't kick 0x4000). B4 partially
    resolved for switch[1..4]. Phase B switch-matrix and lamp-driver status updated.
    Next step: prototype hardware migration.
2026-06-13 Migrate to Cyclone 10 LP target board + pre-fab design verification
    Retarget project from GottFA3/Cyclone IV E test board to the AtariFA-PCB
    (Cyclone 10 LP 10CL006YE144C8G): RAM/ROM/PLL IP regenerated for the new
    device, .qsf device/pinout updated, cpu_clk_gen.vhd (dead code) dropped.
    Pre-fabrication verification fixes in AtariFA.vhd:
    - FRAM fram_i2c_sda: out -> inout (open-drain, idle Z) for I2C ACK/read-back
    - Safe inactive levels for all not-yet-implemented outputs (Phase B/C) so the
    board is safe before wiring: solenoids <= (others => 1) (inverting 74HCT540
    => gate low => MOSFET off), oe_595 <= 1 (active-low), 595/aux/UART idle
    - solenoids_enable <= 1: routed via non-inverting 74HCT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
    [AtariFA.vhd]
2026-06-13 Add game_select: 5 Gen1 games selectable at runtime
    Replace the fixed Middle Earth ROM1/ROM2 instances with a runtime-selectable
    set of 5 Gen1 games, all resident in BRAM and muxed by the game_select DIP.
    - New game_rom.vhd: generic 2K x 8 altsyncram ROM wrapper (init_file as a
    generic), replacing the wizard-generated ROM1.vhd/ROM2.vhd so one entity
    serves all 10 ROM slots.
    - AtariFA.vhd: instantiate game_rom 10x (5 ROM1 "E0" + 5 ROM2 "E00"), collect
    outputs in rom1_douts/rom2_douts arrays, decode game_select (active-low,
    game_idx = not game_select) and mux the active pair; unused codes 5..7 fall
    back to Middle Earth (608/609).
    - .qsf: add game_rom.vhd, drop ROM1.qip/ROM2.qip (ent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
    [AtariFA.vhd, game_rom.vhd]
2026-06-13 Add free-play option (options(3)) via byte-patch overlay
    Each game has a free-play ROM variant (Space Riders: both ROMs). Holding 6
    extra 2K ROMs in BRAM would need +12 M9K (34/30) and not fit the 10CL006.
    The byte diff shows only 42 bytes change across all 6 variants, so instead of
    second ROMs the changed bytes are overlaid combinationally when free play is
    active (options(3), active-low).
    - AtariFA.vhd: FP_PATCHES constant (42 game/slot/addr/data records) + fp_overlay
    process. Raw game-mux outputs rom1_sel/rom2_sel are patched into rom1_dout/
    rom2_dout; bus mux (gated by rom1_cs/rom2_cs) unchanged.
    - rom/freeplay/*.hex: reference/source only (NOT synthesized into BRAM).
    - rom/freeplay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
    [AtariFA.vhd]
2026-06-17 DIP-Konfiguration 6 -> 10 (Boot-Read-Matrix) + Review-Fixes
    Erweiterung der DIP-Einstellungen von 6 auf 10 Schalter:
    - 4er-Block: 3x game_select + 1x freeplay; 6er-Block: 6x options
    - Neue FSM read_the_dips.vhd liest die ersten 6 DIPs im Boot ueber eine
    3x2-Strobe-Matrix (Lampen-IOs serin_595/clk_595/rclk_595 zweckentfremdet);
    DIPs 7-10 (options 3..6) direkt ueber dip_opt, im Spiel dynamisch.
    - Boot-Phasen: boot_phase(0)=sync reset_sw + FSM-Reset, boot_phase(1)=done -> reset_l_stable
    - Top-Ports umbenannt: game_select/options/reset_l -> dip_ret/dip_opt/reset_sw (.qsf)
    - options(3) -> eigenes Signal freeplay
    Review-Fixes:
    - KRITISCH: Strobe-Mux war auf boot_phase(0)='0' gegated -> Strobe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
    [AtariFA.vhd, read_the_dips.vhd]
2026-06-18 Rename boot_message.vhd -> display_control.vhd; fix disp_Adr latch
    Modul beschreibt die Display-Ausgabe-FSM (Multiplex der 4 Player-Displays
    + Status-Display), nicht nur die Boot-Meldung. Datei + Entity + Instanz
    (BM -> DC) umbenannt, Verweise in AtariFA.vhd/.qsf/README.md angepasst.
    Zusaetzlich Warning 10631 behoben: disp_Adr(6) (ungenutztes MSB) wurde nur
    im Async-Reset-Zweig gesetzt -> Latch inferiert. Jetzt getaktet auf '0'
    getrieben (Register statt Latch). Full Compile: 0 Fehler, 73 Warnungen.
    [AtariFA.vhd, display_control.vhd]
2026-06-18 Add boot_phase(2): ~5s version/config display before ROM start
    Nach dem DIP-Read und vor CPU-Freigabe zeigt display_control fuer ca. 5s
    (INFO_SHOW_CYCLES=5e6 @1MHz) die Konfiguration rechtsbuendig an:
    - Disp1: Version SW_MAIN SW_SUB1 SW_SUB2
    - Disp2: Game-Select game_idx (0-7), 2-stellig dezimal
    - Disp3: options(1..6) binaer (Option1 links; ON gelesen als '0' -> '1')
    - Disp4: Freeplay ('1' wenn aktiv)
    - Status: blank
    reset_l_stable wandert von boot_phase(1) auf boot_phase(2); Display-show
    entkoppelt via disp_show <= boot_phase(1). Neuer Timer- + boot_info-Prozess
    und DC-Eingangs-Mux (bi_*/dc_*). Full Compile: 0 Fehler, 68 Warnungen.
    CLAUDE.md + README um Boot-Phase 2 ergaenzt.
    Co-Authored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
    [AtariFA.vhd]
2026-06-19 Fix SDC reset_l->reset_sw + set NUM_PARALLEL_PROCESSORS (warnings cleanup)
    - AtariFA.sdc: set_false_path auf reset_sw (war noch reset_l nach Pin-
    Umbenennung) -> behebt Warning 332174/332049, False-Path greift wieder
    - AtariFA.qsf: NUM_PARALLEL_PROCESSORS 14 -> behebt Warning 18236;
    Wert 14 (nicht 16), da Quartus auf dieser Maschine nur 14 CPUs erkennt
    (sonst Warning 20031 Ueber-Subskription)
    - CLAUDE.md: Build/Compile-Sektion + Erledigt-Vermerk
    Verifiziert: Full Compile 0 errors, 60 warnings (vorher 63), Timing
    fully constrained Setup & Hold, alle Slacks positiv.
2026-06-20 display_control: Timing an Original-Schaltung angeglichen (v2.0)
    Display-Multiplex-Timing aus realer LogicPort-Aufzeichnung des Original-
    Boards vermessen und FSM darauf abgeglichen (Doku: doc/Display_Timing.md,
    ausserhalb des Repos):
    - Blank-Phase ~11 -> ~129 us (neuer St_Blank-Pad-Zustand)
    - Show-Phase ~232 -> ~383 us (St_Show ersetzt St_Wait1/2)
    - 8 statt 7 Digit-Runden (Digit 7 = Leer-Slot) -> ~512 us/Digit,
    4,10 ms/Frame, ~244 Hz, Duty ~75% (vorher ~95% = ~25% zu hell)
    - Timing in Konstanten C_BLANK_PAD/C_SHOW/C_LAST_DIGIT
    - index-sichere display_nibble/status_nibble (entschaerft latenten
    status_d(digit>3)-Ueberlauf)
    Quartus Full Compile (10CL006YE144C8G): 0 Errors, 60 Warnings
    (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
    [display_control.vhd]
2026-06-21 sound: Atari Gen1 Sound-Emulation (sound.vhd) + Original/Onboard-Umschaltung
    Neues Modul sound.vhd bildet die Original-Tonerzeugung nach: D12-Sound-ROM (16 Wellenformen x 32 Samples, aus 82s130.hex verifiziert), Pitch-Teiler (16-Latch1088), 5-Bit-Sample-Zaehler und 1.-Ordnung-Sigma-Delta-DAC. Latch-Decode 0x1080/1084/1088 (Bits 0-3) in AtariFA.vhd.
    Ausgabe per options(3) umschaltbar: DIP OFF = Original (AUDIO 0-3 + Volume-Latch ans Aux-Board, invertiert wg. 74HCT540), DIP ON = Emulation (SB_Sound 1-Bit-PWM -> Onboard RC + TDA7267).
    Schaltungsanalyse + Modell in doc/Sound_Emulation.md (Schaltbilder Display_Logic.png + Auxiliary_PCB.png); README/CLAUDE aktualisiert. Quartus Full Compile: 0 F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
2026-06-22 speech: Boot-Sprachausgabe "Lisü" als 8-Bit-PCM (8 kHz) integriert
    - speech.vhd: PCM-Decoder (Adresszähler + Ratenteiler + Sigma-Delta-DAC),
    kein Delta-Akku; Generics N_SAMPLES=3687, CLK_DIV=6250
    - speech_rom.vhd: 4096x8 (12-Bit-Adresse), 4 M9K, init rom/lisy.mif
    - rom/lisy.mif: 8-Bit-PCM, deutsche Stimme (espeak), Fade-Out 35 ms,
    ungenutzte Worte = 128 (Stille, kein DC-Knall)
    - AtariFA.vhd: Instanz SPEECH_INST, reset=not boot_phase(0),
    start=boot_phase(1), SB_Sound-Mux mit Speech-Vorrang
    - Wechsel 1-Bit-Delta -> PCM wegen Quantisierungsrauschen (zu geringe OSR)
    - Compile 0 Fehler/0 Critical, BRAM 26/30 M9K, Timing ok
    [AtariFA.vhd, speech.vhd, speech_rom.vhd]
2026-07-02 display: Ziffernreihenfolge an HW-Verdrahtung angepasst (gespiegelt)
    Digit-Adresse ist gegenlaeufig verdrahtet (Adr 0 = physisch rechts,
    Adr 5 = links); die Version " 002" erschien als "200 " (auf Prototyp-
    HW festgestellt). Umkehr zentral in display_control.vhd: display_nibble
    (Score-Ziffern d(5-idx)) und status_nibble (s(3-idx)); Player-up-LED-Slot 6
    und unbenutzter Slot 7 bleiben unveraendert. Wirkt fuer Boot-Info UND
    Spielanzeige (Shadow-Buffer). CLAUDE.md-Notiz aktualisiert.
2026-07-02 fix: Boot-Deadlock in Power-on-Reset-Kette behoben + DBG_MODE=3 Boot-Trace
    Der POR-Zaehler (por_active) zaehlte nur herunter, solange reset_l_stable='1'
    ist. reset_l_stable (=boot_phase(2)) steigt aber erst am Ende der Boot-Sequenz,
    die ihrerseits por_active='0' voraussetzt (read_the_dips wird ueber
    i_Rst_L = boot_phase(0) and not por_active im Reset gehalten) -> zirkulaer.
    Folge: alles ausser cpu_clk (freilaufend aus der PLL) blieb statisch, keine
    Display-/Versionsanzeige.
    POR jetzt in eigenem Prozess, gekoppelt an boot_phase(0) (synchronisiertes
    reset_sw) statt an reset_l_stable -> azyklisch; Reset-Taste = voller Reboot.
    Zusaetzlich DBG_MODE=3 (Boot-Trace) legt boot_phase(0..2)/por_active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
    [AtariFA.vhd]
2026-07-02 dips: clk_595/rclk_595 DIP-Strobe-Zuordnung getauscht (HW-Verdrahtung)
    Auf Prototyp-HW festgestellt: clk_595/rclk_595 waren gegenueber der
    Strobe-Indizes vertauscht. Korrigiert: clk_595 <= dip_strobe(2) (Strobe3),
    rclk_595 <= dip_strobe(1) (Strobe2); serin_595 <= dip_strobe(0) unveraendert.
    Nur der dip_strobe-Index im DIP-Lesefenster getauscht; die Lamp-Signale
    (g_clk_595/g_rclk_595, Phase B) bleiben am jeweils korrekten Pin.
    [AtariFA.vhd]
2026-07-03 display+switch: HW-Test-Fixes der Anzeigen + Switch-Matrix, SW-Version 0.0.3
    Ergebnisse aus dem HW-Switch-/Display-Test (Prototyp, Airborne-Avenger-ROM):
    Display-Mapping (alle schaltplan-/HW-verifiziert, 2026-07-03):
    - Ziffernreihenfolge: zentrale Umkehr aus display_control.vhd zurueckgenommen
    (display_nibble/status_nibble wieder linear); Umkehr sitzt jetzt NUR im
    boot_info-Prozess. Das Spiel (Shadow-Buffer) war sonst doppelt gespiegelt.
    - Player-Select-Feld gegenlaeufig verdrahtet -> Sniffer mappt PinMAME-Player
    gespiegelt: P1->display4, P2->display3, P3->display2, P4->display1.
    - Nibble-Paar je Score-Byte getauscht (Low-Nibble rechts / High-Nibble links);
    nur Player-Scores, nicht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
    [AtariFA.vhd, display_control.vhd, switch_matrix.vhd]
2026-07-04 solenoids: 20 Solenoide + Muenztuer-Spulen (solenoid_driver.vhd), HW-getestet OK, SW-Version 0.0.4
    - Neues Modul solenoid_driver.vhd: latcht 0x1080/1084/1088/108C (obere Nibbles + 108C voll
    = 20 Bits), treibt solenoids(1..20) + coin_cntr/lockout; reset/enable-gated
    (Solenoide sicher AUS im Boot/Reset, zusaetzlich zum physischen 540-Gate).
    - AtariFA.vhd: Sichere-Inaktiv-Block ersetzt (solenoids/solenoids_enable/aux_sol_latch
    modulgetrieben, invertiert fuer 74HCT540), sol_wr-Strobe (= sound_cs-Edge), Instanz SOL.
    aux_audio_latch -> 4 Bit; aux_sol_latch(0)=COIN_CNTREN, (1)=LOCKOUT_EN (Pins in .qsf umgelegt).
    - Bit->Ausgang-Zuordnung aus AtariFA-Schaltplan (solenoid_mapping.txt), Doppelb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
    [AtariFA.vhd, solenoid_driver.vhd]
2026-07-04 lamps: 21x4 Lamp-Matrix (lamp_matrix.vhd) + RAM-0x30-0x3F-Sniffer, SW-Version 0.0.5
    Neues Modul lamp_matrix.vhd: multiplexender 21x4-Scanner (84 Lampen) fuer die reale
    Prototyp-HW (12x ULN2003A + Kaskade aus drei 74HC595 + 4 Aux-Strobes). Ersetzt den
    veralteten lamp_driver.vhd (statische TPIC6B595-Kette) -> geloescht.
    - Datenquelle: RAM 0x30-0x3F Write-Sniffer -> lamp_state(127:0) (analog Display).
    - Mapping HW-abgeleitet (9334-Decode Sheet 18A + AtariFA_Lamps.xlsx):
    595-Gruppe N=4*b+L+1, RAM-Offset=L*4+s -> ser_bit=lamp_state[(L*4+s)*8+b].
    - Scan-FSM @clk_50: blanken -> 24 Bit schieben -> rclk -> Strobe -> Dwell
    (~1kHz, native 25% Duty), Anti-Ghost via oe_595-Blanking.
    - Integration At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
    [AtariFA_Lamps.xlsx]
2026-07-04 docs: Lamp-Matrix HW-getestet OK (Lampen-Selbsttest) -> Phase B abgeschlossen
    CLAUDE.md + README.md: Lamp-Matrix von "HW-Test ausstehend" auf "HW-getestet OK"
    geflippt (Lampen-Selbsttest am Prototyp bestanden). Phase B (Switch-Matrix,
    Solenoide, Lamp-Matrix) damit vollstaendig HW-verifiziert.
2026-07-06 switch: NMI 244Hz + 0x200B-Testschalter-Polaritaet gefixt, HW-getestet OK alle 5 Spiele, SW-Version 0.0.6
    Behebt B13 (Switch-Test/Selbsttest ROM-abhaengig instabil). Zwei Root-Causes
    via ROM-Disassembly (tools/dis6800.py) gefunden, s. doc/Switch_Reading_Analysis.md:
    - NMI-Rate war 8x zu schnell: dma_counter 9-Bit /512 = 1953 Hz -> 12-Bit /4096
    = 4096 us = 244 Hz (PinMAME ATARI_NMIFREQ, gemessene Frame-Periode). Der
    Switch-Scan im NMI-Handler registrierte sonst jeden Druck mehrfach.
    - 0x200B-Testschalter war invertiert: ME @7F9C und Airborne @7AB4 werten Bit7
    aus und erwarten Bit7=1 = Test gedrueckt. Fix: 0x200B NICHT invertieren
    (faellt mit allg. DIP-Zweig zusammen); Middle Earth (g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
    [AtariFA.vhd, atari.c, atari.h, atarigames.c]
2026-07-07 audio: Dauerton-Fix (AUDIO ENABLE/RESET) + Sprach-Delay gegen TDA7267-Mute, HW-getestet OK, SW-Version 0.0.7
    - sound.vhd: neuer snd_enable-Port; Ton stoppt jetzt via AUDIO ENABLE (0x3000) /
    RESET (0x6000-0x6FFF) statt nur bei Volume=0 -> Dauerton nach Punktezaehlung weg (HW-OK).
    - AtariFA.vhd: audio_enable-Register (per-game, idx3/4-Sonderfall) treibt snd_enable;
    speech.vhd mit START_DELAY=100000000 (~2s) instanziiert -> "Lisü" spielt erst NACH
    dem TDA7267-Einschalt/Mute-Fenster (war komplett stumm, HW-bestaetigt hoerbar);
    LED_D1-Sprach-Diagnose zurueck auf wd_seen; SW_SUB2 x"6"->x"7".
    - speech.vhd: neuer Generic START_DELAY + Wartezustand in der Ablauf-FSM
    (0 ROM/BRAM, dem --lead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
    [AtariFA.vhd, sound.vhd, speech.vhd]
2026-07-09 fram: I2C-Master (fram_i2c.vhd) + Stufe-1 Save/Restore (Airborne), HW-getestet OK, SW-Version 0.0.8
    - fram_i2c.vhd (neu): Bit-Banging-I2C-Master @clk_50 fuer FM24CL64B (Slave 0x51,
    2-Byte-Adresse, Block-Read/Write, SDA open-drain inout / SCL out).
    - Read-Bug-Fix: P_RX sampelt shreg jetzt genau 1x pro Bit (letzter Takt der SCL-high-Phase)
    statt 125x -> Byte wird MSB-first korrekt zusammengebaut.
    - AtariFA.vhd: FRAM-Record @Adr0 [Magic/game/Credit($D5)/Scores($81-$8A)], persist_sniffer,
    Outhole-Save-Trigger (Airborne offset 67, Score-Stabilitaet), FRAM-Ctrl-FSM
    (Boot-Read bei options(1)=ON / Erase bei OFF), Boot-Info-Verifikationsanzeige.
    - Boot-Info Status-Credit-Nibble in korrekter R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
    [AtariFA.vhd, fram_i2c.vhd]
2026-07-09 fram: Stufe-2 Bus-Injection-Restore (Credit-Restore HW-getestet OK), SW-Version 0.0.9
    - injection-FSM + RAM-Port-Mux + cpu68 halt: haelt die CPU nach dem Boot-RAM-Clear an,
    muxt den RAM-Port und schreibt die restaurierten Bytes aus fram_shadow direkt ins Spiel-RAM.
    INJ_ARM(reset_h=0 + restore_valid + game_idx=2) -> INJ_WAIT_CLEAR(DELAY_CLEAR~20ms) ->
    INJ_HALT(HALT_SETTLE~82us) -> INJ_WRITE -> INJ_DONE (One-Shot pro Boot).
    - HW-getestet OK (Airborne, options(1)=ON): 2 Credits aus dem Vorspiel nach Power-Cycle
    restauriert (Coin -> Credit 3), CPU laeuft sauber weiter.
    - Score-Injektion ($81-$8A) per INJ_SCORES=false ZURUECKGESTELLT: Atari zeigt im Cold-Boot-
    Attract keine Scores (fix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
    [AtariFA.vhd]
2026-07-10 fram: I2C-Modul deaktiviert (NVRAM/Credit-Persistenz zurueckgestellt), Erkenntnisse dokumentiert, SW 0.1.0
    Ausweitung des Credit-Save/Restore (Airborne HW-OK, SW 0.0.9) auf alle 5 Spiele
    abgebrochen: der empirische CRED_PROBE ist unzuverlaessig. HW-Test-Sanity-Anker
    Airborne kam als 240 ($F0) statt 213 ($D5) heraus; ME-Konfidenz konvergiert nie,
    Space verzaehlt. Root-Cause (verifiziert tools/listing_aav.txt): $1D (Credit-
    Display) wird aus vielen Codepfaden geschrieben -- der Attract-Muenz-Scan zaehlt
    $1D direkt hoch, ohne $D5 davor -> "letzter Write vor $1D" ist eine BCD-Scratch-
    Variable statt des Credit-Masters.
    Deaktivierung = AtariFA.vhd/.qsf zurueck auf Pre-FRAM-Baseline (7c0aca2): en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
2026-07-10 doc: Lamp-Refresh-Analyse (EN) - Original = DMA-Hardware, kein SW-Refresh; Vorgluehen = HW-Artefakt
    Definitiv geklaert (PinMAME ram_w + Airborne-ROM-Disasm + NMI-ISR): Atari Gen1
    refresht Lampen per DMA-Hardware, nicht per Software. CPU pflegt nur statisches
    An/Aus-Bild in RAM 0x30-0x3F (Read-Modify-Write EINES Bits, ereignisgesteuert).
    Forum-These 'Refresh-Routine streut ON-Phasen fuer Aus-Lampen ein' trifft auf
    Gen1 NICHT zu -> Vorgluehen ist HW-Artefakt der 20-V-Matrix. LEDs auf AtariFA
    sicher: Refresh aendert nur Duty/Timing, NICHT Spannung; 5-V-Test-LEDs am
    separaten Box-Connector-Pfad. Neue Doku doc/Lamp_Refresh_Analysis.md + Referenz
    in CLAUDE.md.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
2026-08-03 audio: Dauerton am Aux-Board gefixt (AUDIO ENABLE/RESET gatet jetzt beide Pfade), SW 0.1.1
    Symptom (HW): mit options(3)=OFF (Original-Pfad ueber das Aux-Board) lag ab Boot
    ein lauter Dauer-Piepton an; beim Credit-Aufbuchen aenderte sich kurz die Tonhoehe
    und kehrte dann zum Dauerton zurueck. Onboard-Pfad (SB_Sound) war unauffaellig.
    Ursache: der Dauerton-Fix aus SW 0.0.7 (7c0aca2) gatete nur den Emulations-Pfad.
    snd_enable wirkte ausschliesslich ueber eff_volume, und eff_volume wurde nur im
    Sigma-Delta-Prozess benutzt. Der Aux-Pfad lief ungegated weiter: "sample <= nibble"
    sowie aux_audio_latch aus dem ROHEN Lautstaerke-Latch.
    Kernbefund (Airborne-ROM-Disasm + Sheet 15B): das Spiel schalte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
    [AtariFA.vhd, sound.vhd]
2026-08-05 lamps: 595-Kaskaden-Zuordnung auf Excel-Mappe 'aktuell' umgestellt, SW 0.1.2
    Die Zuordnung 74HC595-Ausgang <-> Lampen-Latch/Bit wurde in
    doc/AtariFA_Lamps.xlsx korrigiert (neue Mappe 'aktuell', alte Werte
    bleiben zum Vergleich in Mappe 'alt').
    - lamp_matrix.vhd: bisherige Formel N = 4*b + L + 1 (= Mappe 'alt')
    durch die Tabelle GRP_OF ersetzt; die neue Zuordnung ist eine
    Permutation der 595-Ausgaenge ohne geschlossene Form. St_Load
    iteriert jetzt ueber (Latch, Bit) statt ueber die Gruppennummer.
    Tabelle byte-exakt gegen die Mappe 'aktuell' geprueft (21 Eintraege,
    jede Gruppe 1..21 genau einmal).
    - RAM-Offset-Zerlegung (offset[3:2]=Latch, offset[1:0]=Strobe),
    STROBE_ENC, Shift-Re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
    [AtariFA_Lamps.xlsx]
2026-08-06 Umbau auf gemeinsamen Sourcebaum: zwei Board-Varianten, ein Top-Level
    Zweite Ausprägung (dev_open-Piggy-back-Board) lag als vollständige Dateikopie
    neben dem flachen Projektordner; von 54 Quelldateien unterschieden sich drei.
    Jede künftige Änderung hätte doppelt portiert werden müssen, inklusive zweier
    handgepflegter .qsf.
    Struktur (Vorbild N:\Projekte\WillFA7\FPGA_source):
    top/AtariFA.vhd ein Top-Level für beide Boards
    rtl/common/ Module + version_pkg (SW_SUB1/2) + display_pkg
    rtl/cyclone_10/ Megafunctions der Chipfamilie
    variants/<n>/ variant_pkg (BOARD_ID), device.tcl, pins.tcl, sdc, qpf, cof
    scripts/ gen_qsf.ps1, check.ps1, bui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
    [AtariFA_Lamps.xlsx, baseline.csv]
2026-08-06 docs: User Manual AtariFA HW v1.x (EN), Aufbau analog WillFA7S
    Nutzerseitige Doku, die bisher fehlte: DIP-Bedeutung beider Baenke, Boot-Ablauf
    mit der Info-Anzeige, die beiden Audio-Pfade, Status-LEDs als Diagnosehilfe,
    Freispiel, Board-Varianten, und ein ehrliches Kapitel zu dem, was noch nicht
    implementiert ist (FRAM, ESP32, MP3-Pfad).
    Inhalte gegen den Code verifiziert, nicht aus der Erinnerung geschrieben:
    DIP-Zuordnung aus read_the_dips.vhd (4er-Bank = 3x game_select + freeplay,
    6er-Bank = options 1..6, davon 1/2 ueber die Boot-Matrix und 3..6 direkt),
    Boot-Info-Inhalt und Ziffernlage aus dem boot_info-Prozess, INFO_SHOW_CYCLES = 5 s,
    Speech START_DELAY = 2 s, LED-Bedeutung und die bew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
2026-08-06 docs: deutsche Bedienungsanleitung AtariFA HW v1.x
    Vollstaendige deutsche Fassung des User Manuals, keine Kurzfassung: alle zwoelf
    Kapitel plus beide Anhaenge, gleiche Tiefe wie die englische Fassung.
    Die Kapitelnummerierung ist in beiden Fassungen identisch (29 nummerierte
    Ueberschriften, maschinell gegengeprueft). Ein Verweis wie 'siehe Kapitel 4.3'
    passt damit auf beide - das ist der Grund fuer die gleiche Gliederung und steht
    auch so in CLAUDE.md, damit beim Ergaenzen eines Kapitels nicht nur eine Fassung
    umnummeriert wird.
    Beide Dateien verweisen im Kopf aufeinander, README.md verlinkt beide.
    TOC-Anker beider Fassungen gegen die Ueberschriften geprueft (je 32, alle treffen).
    Co-Autho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
2026-08-08 FA-Control-Schnittstelle: LISY-Slave am ESP32-C3, SW 0.1.3
    Gegenstelle zu N:\Projekte\FA_Control (ESP32-C3 mit Weboberflaeche zum Testen).
    Bisher sendete FA_Control ins Leere -- auf FPGA-Seite gab es keine Gegenstelle,
    und die Anzahl von Lampen/Spulen/Schaltern/Displays musste dort von Hand
    eingetragen werden.
    Protokoll ist LISY API 0.12 unveraendert (lisy_5_28/src/lisy/lisy_api.h), keine
    Eigenerfindung. Neu implementiert ist die Info-Gruppe 0..9 -- das ist der
    Connect-Handshake: der Host fragt Kennung, Version und Bestueckung ab (84 Lampen,
    22 Spulen, 80 Schalter, 16 Sounds, 5 Displays) statt sie geraten zu bekommen.
    Uebernahme nur mit zwei Bedingungen: ESP32_ctrl_req low UND Options-DIP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
    [baseline.csv]
2026-08-08 docs: FA-Control am Prototyp getestet; Totmann-Test war nicht durchfuehrbar
    Der Hardware-Test ist gelaufen und die Schnittstelle funktioniert. Alle Stellen,
    die noch "noch nicht HW-getestet" behaupteten, sind nachgezogen: Kopf von
    docs/FA_Control_Interface.md, der Hinweiskasten in Kapitel 9 beider Handbuecher,
    die Abschnittsueberschrift in CLAUDE.md und die pcb-Zeile in baseline.csv.
    cyclone_10_dev_open bleibt ungetestet, das steht weiterhin so da.
    Korrigiert, vom Nutzer im Test aufgefallen: Schritt 5 der Inbetriebnahme lautete
    "USB-Kabel des ESP ziehen. Nach ~2 s muessen alle Ausgaenge abfallen." Das ist
    nicht durchfuehrbar - der ESP haengt an den 5 V der AtariFA und braucht im
    Betrieb ueb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
    [baseline.csv]
2026-08-08 .gitattributes: Zeilenenden im Repository auf LF vereinheitlichen
    Reine Zeilenenden-Aenderung. Kein Byte Inhalt, kein Verhalten.
    Hier stand `* -text` ("Zeilenenden so einfrieren, wie sie committet sind") mit der
    Begruendung, eine Umstellung wuerde das halbe Repository ohne Gewinn umschreiben.
    Die Begruendung hat sich ueberholt: `-text` haelt nur GIT davon ab, Zeilenenden
    zu aendern - es haelt kein Werkzeug davon ab, eine Datei beim Speichern von LF auf
    CRLF zu kippen. Beim FA-Control-Umbau ist genau das reihenweise passiert, und
    jede betroffene Datei landete als Ganzdatei-Diff im Commit, in dem drei Zeilen
    geaendert waren; das musste jedes Mal von Hand zurueckgestellt werden.
    Mit `text=aut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
2026-08-09 lamp_matrix: widen the last shift clock; add the DBG_MODE 4/5 lamp trace
    docs/Lamp_Refresh_Analysis.md argued from PinMAME, a ROM disassembly and the DMA
    architecture that Atari Gen1 has no software lamp refresh, so the forum claim about
    on-phases being injected for switched-off lamps to keep the filaments warm cannot
    apply here. That was a paper argument. This turns it into a measurement and records
    the outcome.
    DBG_MODE 4 (long capture, event channels stretched to 1 ms so they survive a slow
    sample raster) exposes every CPU write to lamp RAM 0x30-0x3F, whether that write
    changed the byte, whether it set a bit 0->1, the state and the drive of one watch
    lamp, "any lamp currently driven" as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
    [baseline.csv]
2026-08-09 repo: keep the internal working notes out of the public tree, publish WORKFLOW.md
    CLAUDE.md, PLAN_Zielstruktur.md and VARIANTEN.md are workstation notes: the context
    file for the assistant, the rationale for how the source tree is laid out, and the
    record of which board variant has actually been on hardware. They are useful here and
    noise in a public repository, so they move to .gitignore and out of tracking. The
    files themselves stay on disk - this only removes them from the repo.
    WORKFLOW.md is the opposite case: how to change something in this tree, run
    check.ps1 -Fit against the baseline and cut a release is exactly what an outside
    reader needs, so it moves to docs/ where the rest of th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
2026-08-09 version: SW 0.1.4
    Carries the lamp_matrix St_ShiftLast fix of the previous commit, so a flashed board
    can be told apart from a 0.1.3 that still has the 20 ns shift pulse. No user visible
    change otherwise - the fix widens one clock pulse, it does not alter behaviour.
    Only the places that state the version as a FACT were updated: the header of both
    manuals, the two "what the info display shows" examples, the sample answer to LISY
    opcode 1, and the commissioning check in docs/FA_Control_Interface.md, which asks the
    tester to confirm the info line reads "AtariFA / 0.1.4 / 0.12" - that one would have
    raised a false alarm on the next run. Every historical statement ("new in 0.1.3",
    "since SW 0.1.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
    [baseline.csv]
2026-08-09 release: SW 0.1.4 artefacts for both boards
    scripts\release.ps1 built every active variant, copied the artefacts to bin\ and
    appended bin\changelog.txt. First release through this script, so bin\ starts here.
    bin\AtariFA_PCB\AtariFA_v014.jic 0.1.4 sha256:F22304F14500A849
    bin\dev_open\AtariFA_v114.jic 1.1.4 sha256:E5FEFDB46FF49BE3
    The file name carries <BoardId><SW_SUB1><SW_SUB2>, so v014 is the AtariFA PCB and
    v114 the dev_open board - one version, one digit apart, exactly what the shared
    version_pkg is for.
    The changelog was written with a UTF-8 BOM (Add-Content -Encoding UTF8 on Windows
    PowerShell 5.1 does that); stripped, so the file starts on its first real line.
    cyclo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
    [baseline.csv]
2026-08-09 release: name the pcb bin folder FPGA_board_v4.x
    bin\AtariFA_PCB became bin\FPGA_board_v4.x, which is how the folder is named for the
    other boards here. Only the artefact moved - same file, same checksum; the changelog
    lists file names, not folders, so it stays correct.
    release.ps1 itself needed no change: it takes the folder from BinFolder in
    variants\<name>\variant.psd1, and that was the only place the old name appeared.
    Also corrected the Notes line in the same file, which still claimed the lead variant
    was tested through SW 0.1.2 - it is 0.1.4 since yesterday's flash and play session.
    Note that the v0.1.4 tag predates this rename, so the tagged tree still carries
    bin\AtariFA_PCB. The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
2026-08-09 docs: trace the lamp "keep-alive" claim to Atari's own manual
    The Troubleshooting Guide section "Lamp Strobes" is where the pre-glow /
    keep-alive claim comes from - not pinball forums. Its timing figures
    (4 mutually exclusive strobes, every 2 ms, ~500 us each, 25 % duty)
    independently confirm the DMA model of section 1 and correct section 5(a):
    the original lamp frame is ~488 Hz, twice the 244 Hz display frame, so
    AtariFA runs 2x faster than the original, not 4x. Duty - and therefore
    brightness - is identical.
    The follow-up question is settled too: the Aux board has no keep-alive
    circuit and cannot have one. Its 7402 1-of-4 decoder has no enable input,
    so exactly one column is live at every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
2026-08-10 lamps: scan at the original 488 Hz frame, release SW 0.1.5
    DWELL_CYCLES 12500 -> 25100 in lamp_matrix. The blanking window is 500 clocks
    (10.000 us, measured on the logic analyser after St_ShiftLast), so a strobe
    phase now lands on 25600 clocks = 512.00 us - one display digit slot, exactly
    the column time of the original DMA chain. Frame 2.048 ms = 488.3 Hz, duty
    24.5 %. It used to be 250 us / 961 Hz, twice as fast as the original.
    Brightness does not change: duty moves 24.04 -> 24.5 %, and the frame rate
    never mattered for it in the first place. The reason is the pre-glow
    observation planned on the machine - holding AtariFA and the original MPU
    against each other on one playfield compares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
    [baseline.csv]
2026-08-10 lamps: kill the LED pre-glow, keep the original timing on Option DIP 5
    Measured on an Airborne Avenger playfield on 2026-08-10 with LED retrofits
    and FA-Control: driving a single lamp made exactly the LED at "same row,
    previous column" glow, and only that one (lamp 22 on => 21 glowed, 58 => 57).
    Incandescent lamps showed nothing. Identical on SW 0.1.3, 0.1.4 and 0.1.5,
    i.e. independent of the lamp frame rate (961 Hz vs 488 Hz), so the window is
    set by hardware, not by DWELL_CYCLES.
    That is the mechanism docs/Lamp_Refresh_Analysis.md 3.3 predicted, and it
    proves it - but it also corrects this repo: "AtariFA blanks and does not
    reproduce the artifact" was wrong. The logic analyser run of 6.7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
    [baseline.csv]
2026-08-13 release: SW 0.1.7 - three dead-time steps for the lamp columns
    The ~20 us of 0.1.6 were enough on an Airborne but left one LED half lit on a
    Middle Earth, so the dead time between the column change and the rows going live
    is now selectable: ~60 us as the series value (SETTLE_CYCLES 2500) and ~110 us on
    Options DIP 6, while DIP 5 = ON still restores the original timing. The phase
    length stays 512 us in all three positions - the dwell absorbs whatever the dead
    time does not need, so a playfield comparison changes one variable, not two.
    Field feedback from two machines confirms both 0.1.6 fixes: the DIP 5 A/B
    reproduces the pre-glow on command, and the base glow of the LED retrofits is
    gone. S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
    [baseline.csv]
2026-08-13 release: SW 0.1.8 - measurement build, 400 us of column dead time on DIP 6
    Not a series standard, and the changelog says so. One constant against 0.1.7:
    SETTLE_LONG_CYCLES 5000 -> 20000, so Options DIP 6 = ON gives ~400 us of dead
    time between the column change and the rows going live instead of ~110 us. The
    dwell absorbs it as always, so the phase stays 25600 clk = 512 us, but the duty
    drops to 5.0 percent instead of 22.1 - three quarters of the brightness, which is
    the whole reason this is a measurement build and not the new default.
    It answers one question. The 0.1.7 field feedback had DIP 6 change nothing at 595
    group 6 (ULN2003A A20, FA-Control lamps 20..23), and per the base-charge es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
    [baseline.csv]
2026-08-13 docs: desk measurement clears the lamp data path at the component
    Ran the bench procedure of Lamp_Preglow_Experiment.md 6.3 on cyclone_10_pcb with
    DBG_MODE 5 / DBG_WATCH_LAMP 21 and wrote the numbers into a new 6.3.1. Measured at
    the ULN input (A20 pin 1), not at the FPGA pin, which was the whole point:
    lamp 21 alone test LED bright, 1.0 V DC = exactly the multiplex average
    predicted for 22.1 percent duty, so the group net is driven in
    one phase out of four and the mapping and phase are right
    all lamps off 0.2 mV against a 0.0 mV zero reference, and the analyser never
    triggered over minutes: duty <= 0.004 percent (~90 ns per fra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
2026-08-13 docs: Middle Earth reports 0.1.7 fixes its lamp glow - Airborne version unverified
    Field feedback 2026-08-13, verbatim: "I loaded 017 software and the lighting issue
    is fixed. The lights all work as they should, that extra timing delay to make up
    for my original auxiliary board seems to have worked."
    That is the confirmation section 3.3 was waiting for: the longer dead time removes
    the glow on a real machine, so the mechanism is now backed by its countermeasure
    and not only by measurement. Still to ask: was DIP 6 ON or OFF there? It decides
    whether the 60 us series value is enough or whether the 110 us of DIP 6 are needed,
    and therefore what the next series value should be.
    Flagged in 6.1,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
    [baseline.csv]
2026-08-13 release: SW 0.1.9 - four dead-time steps for the lamp columns on DIP 5 + 6
    The column dead time becomes a ladder instead of a single long step, and this
    supersedes the 0.1.8 measurement build. Options DIP 5 and 6 now form one 2-bit
    field, DIP 5 the high bit so the positions read left to right the way the boot
    info display shows them:
    OFF OFF ~65 us series value SETTLE_CYCLES 2750 duty 21.8 %
    OFF ON ~250 us SETTLE_LONG_CYCLES 12000 duty 12.8 %
    ON OFF original MPU timing no dead time duty 24.5 %
    ON ON ~400 us SETTLE_MAX_CYCLES 19500 duty 5.5 %
    DIP 5 alone and DIP 6 alone therefore keep the meaning they had in 0.1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
    [baseline.csv]
2026-08-31 release: SW 0.2.0 - FA-Control solenoid numbers are 1-based
    Tile n is driver Qn of the schematic, 21 is the coin counter and 22 the
    coin door lockout. LISY counts coils that way (lisy_5_28/src/lisy/lisy_w.c,
    "sol number starts with 1") and so does the original documentation, which
    made the previous 0..21 the odd one out - a real LISY host would have hit
    the second coil when sending 1 and could never reach the 22nd at all,
    because par1 < N_SOL rejected 22.
    Four opcode handlers in rtl/fa_control/fa_control.vhd changed (G_STAT_SOL,
    S_SOL_ON, S_SOL_OFF, S_PULSE_SOL): the range test is now par1 >= 1 and
    par1 <= N_SOL, the vector index is par1-1. sol_r stays 0-based, so the top
    level and its gen_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
2026-08-31 SW 0.2.1: 0x2000 is a dip position, not just the DMA sync
    dip_value for 0x2000 is now (6 => dma_toggle, others => sw_state(0)) -
    a normal dip read with only bit 6 overwritten by the display sync, exactly
    as PinMAME dipg1_r does it for offset 0:
    return toggle ? (dipram[0] | 0x40) : (dipram[0] & 0xbf);
    It used to be a synthesised byte, ("0" & dma_toggle & "111111"): bit 7 hard
    0, bits 5..0 hard 1. That matched the two evaluated bits only with the dip
    OFF, which is the coin/credit factory setting - a CLOSED dip 0 was invisible
    to the game, while FA-Control showed it correctly on tile 0 because
    fa_sw_state comes raw from sw_state.
    Rom proof, written up in docs/Switch_Reading_Analysis.md: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
    [AtariFA.vhd, version_pkg.vhd]
2026-08-31 release: SW 0.3.0 - background music over the DFPlayer Mini
    The output SB_Audio, tied to a constant '0' until now, becomes a 9600 baud
    8N1 uart to the RX pin of the DFPlayer Mini fitted as Audio1 - confirmed on
    the hardware for both boards (pcb PIN_7, dev_open PIN_111). New module
    rtl/common/dfplayer_cmd.vhd; the sender is a second instance of the existing
    rtl/fa_control/uart_tx.vhd with g_CLKS_PER_BIT 5208, not the GottFA1_PLuS
    home-made shifter on its own 9600 Hz clock - one clock domain fewer and
    nothing to add to the sdc. Frame is 7E FF 06 <cmd> 00 <par1> <par2> EF,
    8 bytes without checksum, as in GottFA1_PLuS where it is proven in the field.
    Trigger is the flipper control relay Q12, la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
    [baseline.csv]
2026-08-31 release: SW 0.3.2 - background music that finally plays
    Two changes in one release; 0.3.1 was never released on its own.
    0.3.1 - the trigger moved from the flipper control relay Q12 to the OUTHOLE
    SWITCH. Q12 was not merely imprecise on three of the five games, it was wrong.
    Only Middle Earth and Space Riders drive a flipper control relay and hold it for
    the whole game (Middle Earth inline at 7F36 and 77BC, Space Riders through timer
    0x0064 set to 0xFF at 719D, which the driver never decrements because 7A94 skips
    on a negative value). Airborne Avenger and Time 2000 use latch 0x1088 bit 6 for a
    time limited gate - the Airborne manual Table 5 names it "1 Gate -> Q12" - and
    The Atarians uses i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
    [baseline.csv]
2026-08-31 docs: back the five outhole switch numbers with rom evidence, and a bench procedure
    No rtl change, no version bump, the artefacts in bin/ stay the ones from SW 0.3.2.
    Prompted by a reasonable objection: the manual overview
    Manuals\Atari Schalterzuordnungen und Kontakttestcodes.pdf shows OTHER numbers than the
    50/53/56/56/67 in the code. It does, and both are right - the same switch carries four
    different numbers and nothing said so next to the outhole table:
    sw_state offset = cpu address - 0x2000 = manual switch number + 15
    So the manual says 35/38/41/52 where the fpga says 50/53/56/67, and the FA-Control tile
    number is the offset again. That is exactly the confusion that produced the o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
    [baseline.csv]
2026-09-02 variant: cyclone_IV_dev_open, the first board on a second chip family
    The same 'dev_open' piggy back board as cyclone_10_dev_open, but populated
    with a Cyclone IV E EP4CE6E22C8 instead of the Cyclone 10 LP. BOARD_ID 2, so
    the boot info display reads 2.3.2.
    This is the first real use of the RtlFamily key in variant.psd1 and of the
    scripts/files_<family>.tcl mechanism - until now every variant shared one
    chip. rtl/cyclone_IV/ is rtl/cyclone_10/ with the string
    intended_device_family replaced and nothing else: three lines per .vhd, one
    per .qip, one in cpu_clock.ppf. The altpll parameters are family independent
    (clk0_divide_by 50 out of 50 MHz -> 1 MHz cpu_clk, pll_type and
    bandwidth_type AUTO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
    [baseline.csv]
2026-09-02 release: SW 0.3.3 - artefacts for the third board variant
    No functional change to the logic. This release exists so cyclone_IV_dev_open
    gets a .jic of its own without overwriting the shipped .3.2 files, which is
    why only SW_SUB2 moves, 2 -> 3, and all three boards follow.
    bin/FPGA_board_v4.x/ AtariFA_v033.jic 0.3.3 sha256:53727C84E63B150C
    bin/dev_open/ AtariFA_v133.jic 1.3.3 sha256:B9F3FF033B220372
    bin/dev_open_cyclone_IV/ AtariFA_v233.jic 2.3.3 sha256:F3C64BFFA0CAEFCB
    Synthesis, from the release build, baseline.csv updated to match:
    cyclone_10_pcb 4569 1544 202752 LEfit 4649 slack 2.264
    cyclone_10_dev_open 4574 1544 202752 LEfit 4659 slack 2.603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
    [baseline.csv]
2026-09-04 docs: both manuals up to SW 0.3.3 and the third board variant
    Header version 0.3.0 -> 0.3.3 and doc revision v1.1 (04.09.2026), plus every
    place that quoted a stale version number: the info display example in 5.2 was
    still showing 012 / software 0.1.2, the music troubleshooting in 8.4 asked for
    032, and the FA-Control capability table in 9.4 gave 0.3.0 as the example.
    Chapter 12 carried the bigger gap. It knew two piggy-back boards; since
    02.09.2026 there are three, and the new cyclone_IV_dev_open is the first one on
    a different chip family (EP4CE6E22C8 instead of the Cyclone 10 LP), board id 2.
    The table now has an FPGA column, the "apart from the pin assignment" paragraph
    covers both dev_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
2026-09-04 docs: the cookbook after all five name files are finished
    All five AtariFA/<game>.cfg exist now (000 Atarians 54 lamps, 001 Time 2000 47,
    002 Airborne 62, 003 Middle Earth 49, 004 Space Riders 52), so the document
    stops promising "the rest is legwork" and records what the legwork actually
    turned up. Solenoids: Atari Spulentreiberbelegung Gen1.pdf really is the same
    table for all five games - the text does extract, just not with the built-in
    reader; pdftotext -layout from the mingw64 git-bash does it. That corrected two
    entries in 002.cfg (Q3 extra ball meter, Q20 total plays - meters, which table 5
    does not list at all), and all five files now carry all 22 numbers with NOT USED
    on the unfitt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
2026-10-23 index.html generated from the manuals, description per manual
    Every manual carries <meta name=description> now; make_index.ps1 builds the landing page from the manuals in docs/ (title, language, description).
2026-11-03 User manuals: cyclone_10_pcb is prototype only, free play in game select table
    - Chapter 12: cyclone_10_pcb is only for the prototype (hardware
    version 0.7); PCB v1.x uses one of the 'dev_open' variants.
    - Appendix A: Dip4 column, the five games with free play added,
    every 'on' highlighted.
    - README: variant table corrected accordingly.
2026-11-10 release: SW 0.3.4 - Space Riders free play no longer shows 07 on player 3
    The fault was in the free play rom spacerf itself, not in the FPGA overlay
    (gen_patches.py --check confirmed base + FP_PATCHES == spacerf.hex byte for
    byte). Its credit check patch at 0x7752 read 97 04 = STAA $04. The start
    routine at 0x76B2 calls that code only with A = 07, so 07 landed in RAM
    $0004, which PinMAME ram_w maps to the last two digits of player 3. The game
    start clears the displays again on the first start, adding player 2 does not.
    Fix: 0x752/0x753 -> 01 01 (NOP NOP), checksum byte 0x000 42 -> DB so the rom
    byte sum stays 00. spacerf.hex and FP_PATCHES changed in data only, still 42
    entries. The other f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
2026-11-11 SW 0.4.2: last scores and high score per game in the FRAM
    - score_keeper.vhd (new): game-independent, works on the display shadow
    buffers and the player-up game detection. At game end the four scores
    are saved per game (16-byte slot in the FM24CL64B); after power-on the
    last scores are shown until the first game starts, and in attract mode
    the high score alternates with the normal display (8 s / 4 s).
    Nothing is written into the game RAM; credits are not restored yet.
    - fram_i2c.vhd back in the build (files_common.tcl, all .qsf regenerated).
    - DIP 2 (options(2)): ON = feature on; OFF = feature off, the slot of the
    selected game is erased at power-on and nothing is saved.
    - Boot i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
2026-11-11 SW 0.4.4: credits survive a power cycle, all five games
    - Credit counter per game, found by ROM disassembly: Atarians $CE,
    Time 2000 $D6, Airborne $D5 (binary), Middle Earth $1D (the credit
    display byte itself), Space Riders $B7; all others BCD. Apart from the
    coin/start routines only the boot RAM clear writes these addresses.
    - Every CPU write to the counter is sniffed; a change is written to the
    game's FRAM slot right away (score_keeper: slot now 17 bytes at
    game*32, byte 16 = credits, new magic A6 - slots from 0.4.0..0.4.2
    read as empty).
    - 50 ms after each CPU start (also after an FA-Control takeover) the CPU
    is halted and the saved credits are written into the game RAM, pl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
2026-11-11 docs: user manuals v1.2 and FRAM docs for SW 0.4.4, new baseline
    - User manuals EN/DE/FR (v1.2, 11.11.2026): option 2 = save credits,
    high score and last scores (ON = on, OFF = off + erase at boot);
    info display shows FRAM status (player 4, left) and saved credits;
    chapter 6.3 rewritten, chapter 13 has nothing left; appendix B.
    Chapter numbers unchanged in all three.
    - docs/FRAM_Persistence.md: new section "SW 0.4.x" with the credit
    addresses of all five games, injection, slot layout, boot info;
    the 0.0.8..0.1.0 Airborne work stays below as history.
    - docs/Background_Music.md: options(2) is no longer free.
    - scripts/baseline.csv: SW 0.4.4 numbers of all three variants
    (both dev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
2026-11-11 release: SW 0.4.4 - credits, high score and last scores survive a power cycle
    Option DIP 2 ON saves credits, high score and the last scores of each of
    the five games in the FRAM; OFF switches it off and erases the selected
    game at boot. Credit counters found by ROM disassembly (Atarians $CE,
    Time 2000 $D6, Airborne $D5, Middle Earth $1D, Space Riders $B7) and
    written back after every CPU start. User manuals v1.2 describe it.
    Artefacts: bin/FPGA_board_v4.x/AtariFA_v044.jic,
    bin/dev_open/AtariFA_v144.jic, bin/dev_open_cyclone_IV/AtariFA_v244.jic.
    Memory 202752 unchanged, LE 96 % on all three, timing met.
    cyclone_10_pcb tested OK on the bench (2026-11-11); the two dev_open
    variants are built,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
2026-11-12 FA_Control: switch number is not the self-test number
    Wire number = CPU offset (addr - 0x2000); the self test counts from $2010 = 1,
    i.e. offset - 15. Comment and interface doc claimed both were the same.
    FA_Control v1.29 relabels the tiles; no logic change here.
